PRouzeau/Lily-Big/README.md

# Lily-Big
Boxed delta 3D printer, recycling filtration, kinematic positioning on effector. Print space diam 300 x height 400

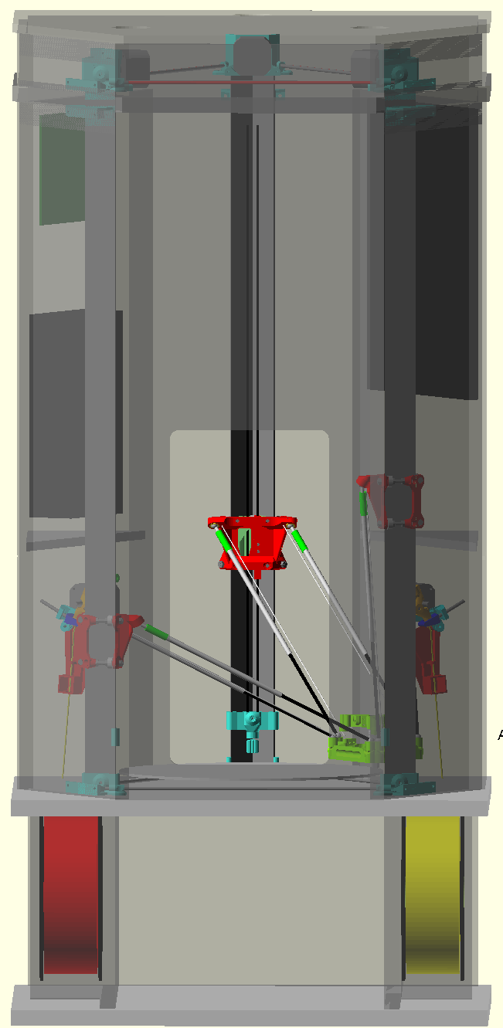
[picture p1: Images/Lily-Big02.png]
Presentation image Example viewed in 3D
