PRouzeau/Lily-Big/Kinematic.odt

As already published in this forum, I am using the wire tensioning system on my two printers since 6 month now, first on the D-Box http://rouzeau.net/Print3D/DBox, then on the Lily http://rouzeau.net/Print3D/Lily.

Retainers are magnets on the D-Box, and rubbers bands on the Lily, to save weight.

The bowden tube tend to pull the hotend support for probe points at the largest diameter, so I had to increase the hotend support pulling value to a minimum. I settled to ~1kg for both machines.

The repeatability is very good in a fixed context, however, the load needed to operate the ‘sensor’ make you machine to deflect of a significant amount, giving a probing offset. As the machine deformations are not the same on all the bed area, you shall individualise offset for each probe point, with calibration done with the sheet paper method.

The offset variability depends a lot of the overall machine stiffness. For the D-Box, I had initially an offset of ~0.4~-0.5mm, with a variability of ~0.15mm. When I replaced the arms by stiffer ones (the weak point was the screwing in plastic on the arms themselves), that reduced sufficiently the offset variability between all points that I abandoned individual offset to a common one, which is now a constant of 0.5 mm for all probing points.

The Lily, while a smaller machine, is a bit less robust (its mechanics cames from the Fisher Delta) and the offset variability remains significant throughout the bed, with values ranging from 0.35 to 0.45 (I have eliminated one point which is off plane).

The only problems I experienced so far :

*I had to retighten the standoffs as their screws tend to became loose with time.

*Heating the D-Box chamber (~70°C)/the bed (tested at 130°C) have driven to effector bending due to wire tension, needing to raise the effector to avoid magnet contacts making the sensor inoperative. The material used (PETG) cannot cope with these temperature tests.

In the Lily « F », there is only yet an halogen spot of 50W which raise slowly the chamber temperature to ~38°C while printing. I will install a heated bed of 100~120W, and will report the obtained temperature (expected below 55°C for Bed 100°C).

ABS may be a better material than PETG, but was not possible for me when I built both printers (no heat bed).
