PRouzeau/Lily-Big/Images/Lily-Big01.png

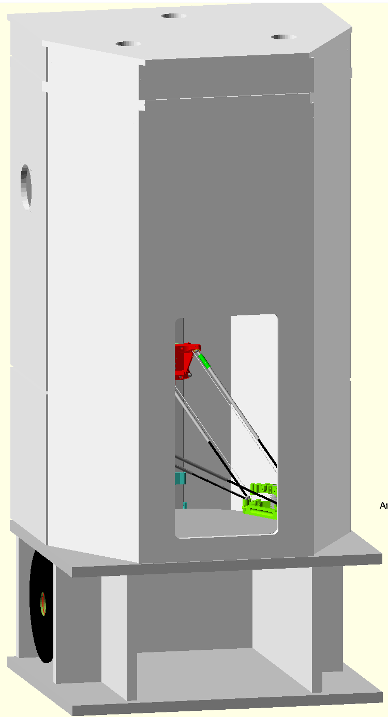
Images/Lily-Big01.png
