PRouzeau/Lily-Big/Images/Lily-Big03.png

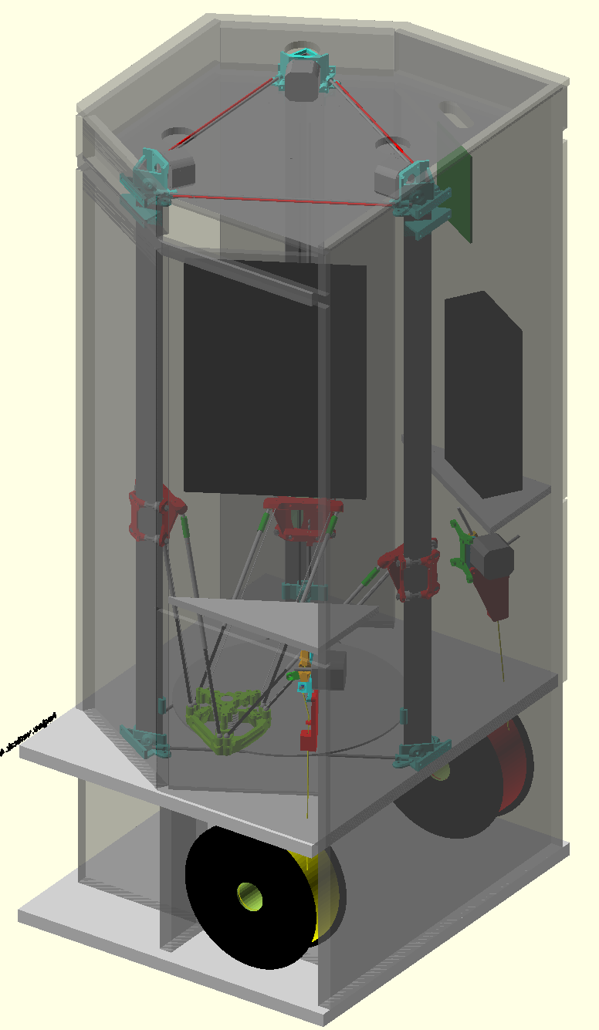
Images/Lily-Big03.png
