PRouzeau/Lily-Big/Images/Lily-Big04.png

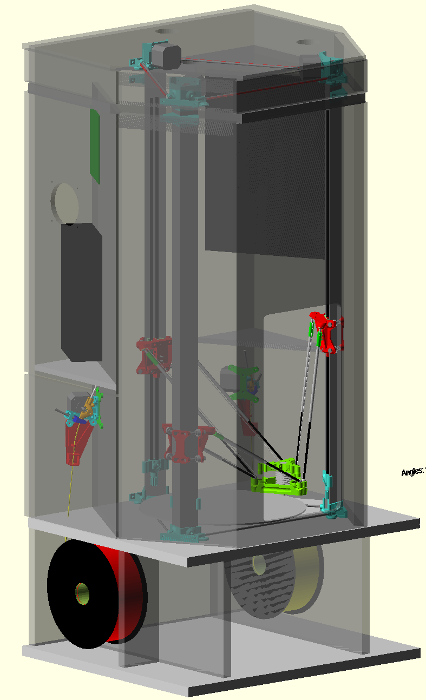
Images/Lily-Big04.png
