PRouzeau/Lily-Big/Images/P1060551.jpg

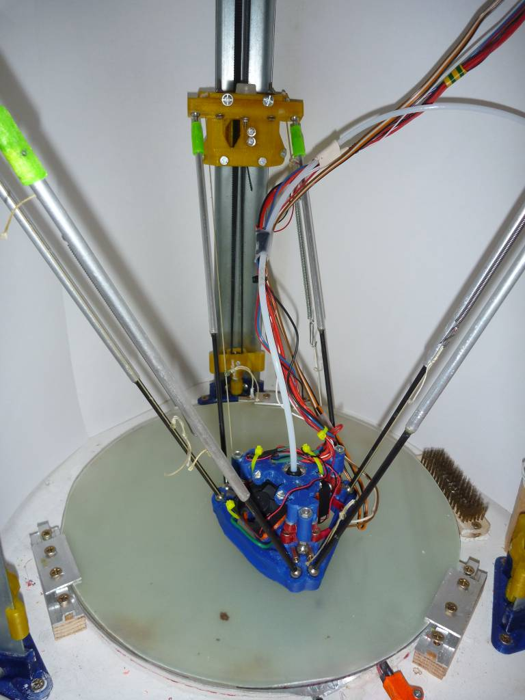
Images/P1060551.jpg
