PRouzeau/Lily-Big/Images/P1060555.jpg

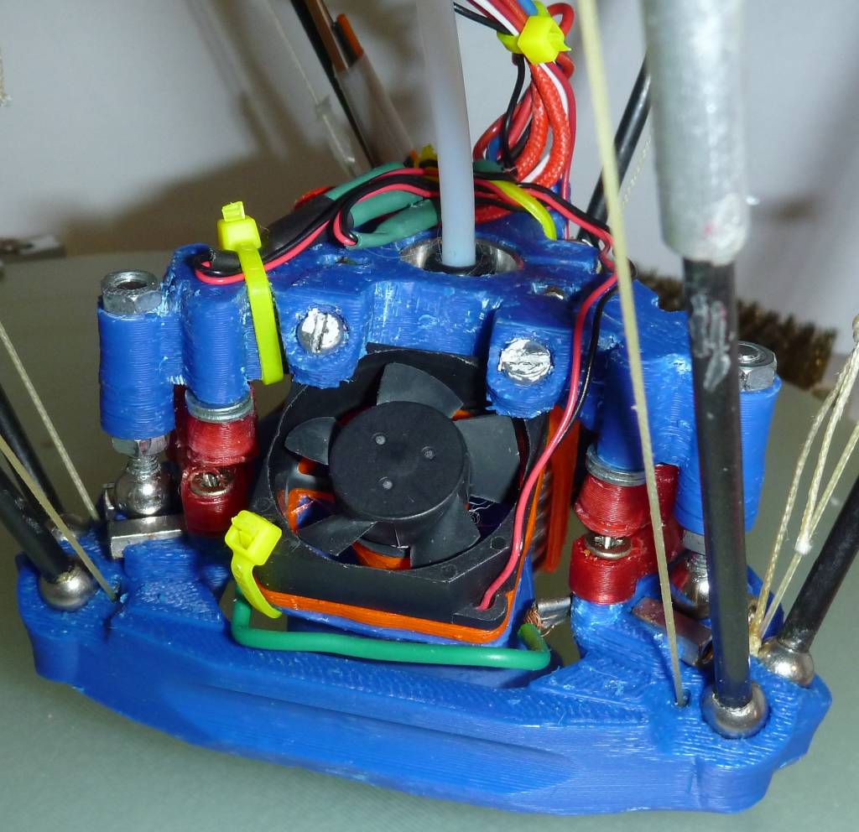
Images/P1060555.jpg
