PRouzeau/Lily-Big/Images/P1060560.jpg

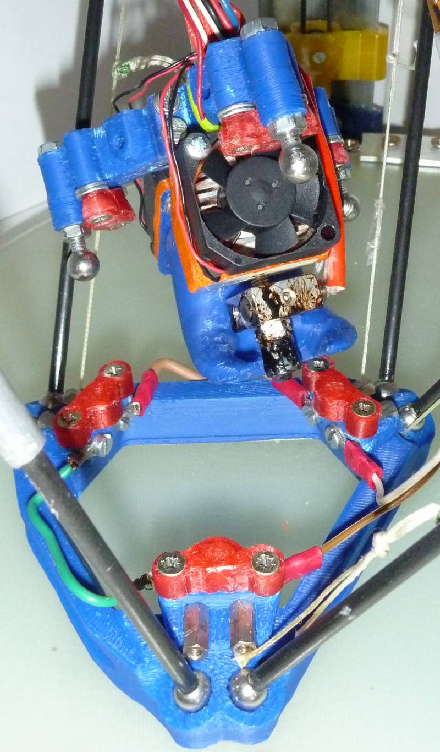
Images/P1060560.jpg
