PRouzeau/Lily-Big/Images/P1060565.jpg

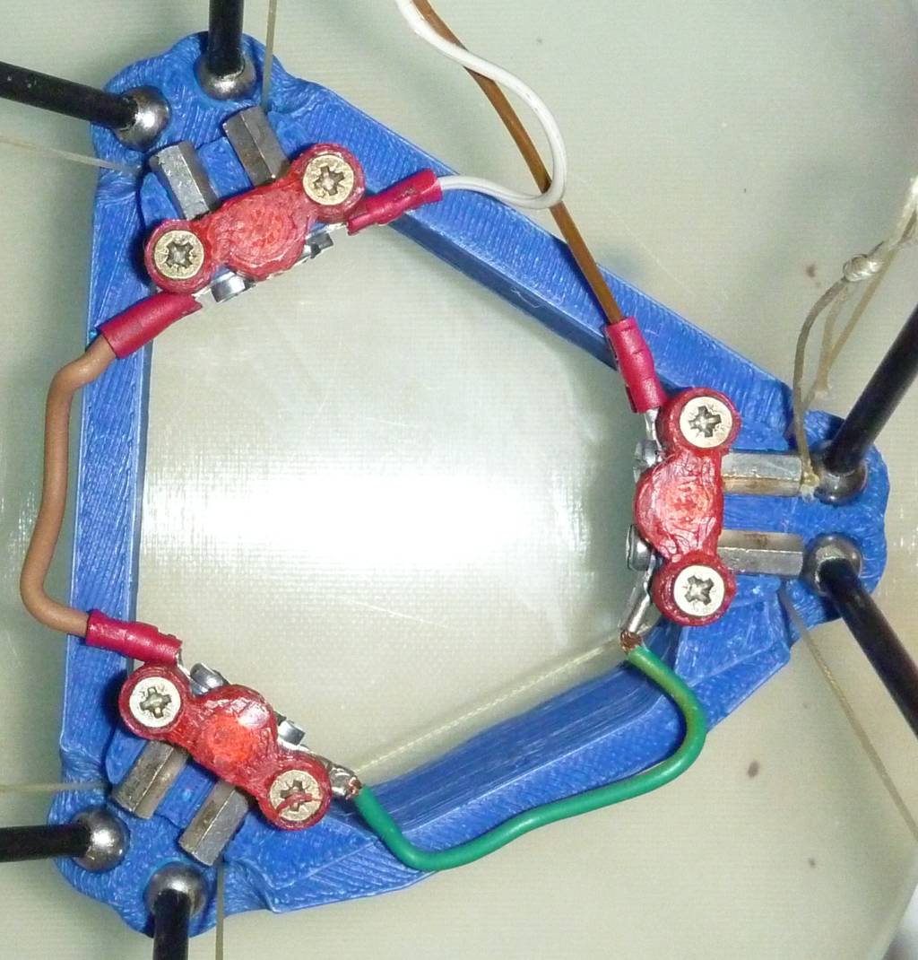
Images/P1060565.jpg
