PRouzeau/Lily-Big/Images/P1060567.jpg

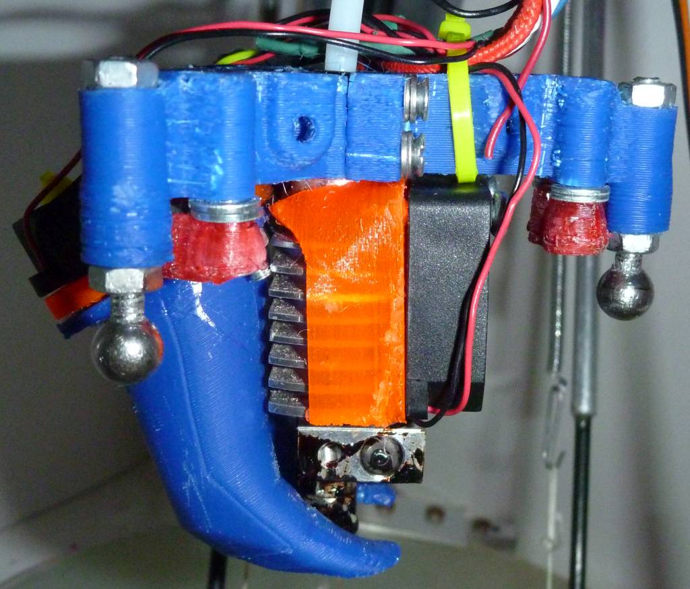
Images/P1060567.jpg
