PRouzeau/Lily-Big/Images/P1060569.jpg

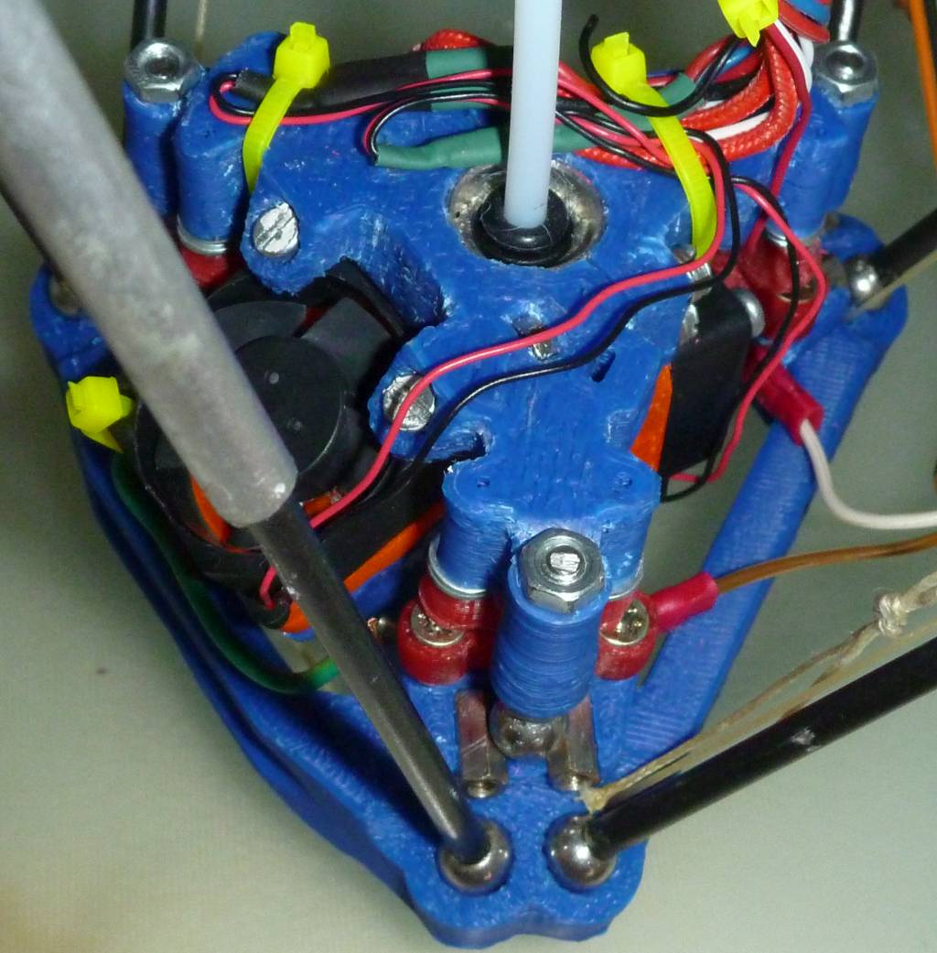
Images/P1060569.jpg
