PRouzeau/Lily-Big/Lily_big_BOM.ods

Sheet: Bolts and Nuts
 | D-Box list , may need update for Lily BIG
 | Size | Usage | Qty | Mult | Total | M3 screws
1 | COLUMNS |  |  |  |  | Cap head
2 | countersunk head screw M4x40 | Carriage ball bearing axis | 4 | 3 | 12 | M3x10 | 12
3 | countersunk head screw M4x10 | Central pusher, bottom | 2 | 3 | 6 | M3x15 | 6
4 | cap head screw M4x20 | Central pusher, top | 2 | 3 | 6 | M3x20 | 12
5 | Domed head M4x20 | Angles anchorings on support | 4 | 3 | 12 | M3x25 | 7
6 | Domed head M4x20 | Top support anchoring | 4 | 3 | 12 | M3x30 | 6
7 | cap head M4x40 | Tensioner | 1 | 4 | 4
8 | Nuts M4 |  | 23 | 3 | 69 | countersunk head
9 | Small washers M4 |  | 13 | 3 | 39 | M3x8 | 8
10 | Cap head screw M3x15 | Belt locker attach | 2 | 3 | 6 | M3x10 | 4
11 | cap head screw M3x20 | Ball bar attach | 2 | 3 | 6 | M3x15 | 2
12 | Cap head M3x10 | motor attach (W/ cork insulator) | 2 | 3 | 6
13 | Cap head M3x25 | Top rubber stop attach | 1 | 3 | 3 | Standoffs
14 | Cap head M3x30 | bottom motor bar attach | 2 | 3 | 6 | M3x10 | 6
15 | countersunk head screw M3x25 | Idler bearings | 1 | 3 | 3 | M3x25 | 4
16 | Nuts M3 |  | 8 | 3 | 24
17 | Medium washers M3 |  | 12 | 3 | 36 | nuts | 36 | 57
18 | Rods M4 * 333 | column positioning | 2 | 3 | 6
19 | M4 nuts | '' | 8 | 3 | 24
20 | M4 small washers | '' | 8 | 3 | 24
21 | EFFECTOR |  |  |  |  | washers S | 4
22 | Cap head M3x10 | Kinematic standoff attach | 6 | 1 | 6 | washers M | 48 | -18
23 | Cap head M3x20 | Fan attach | 2 | 1 | 2 | washers L | 4
24 | Cap head screw M3x20 | Hotend support assembly | 4 | 1 | 4
25 | Round or hex standoff M3x10 | Kinematic standoff | 6 | 1 | 6
26 | Medium washers M3 |  | 6 | 1 | 6 | M4 screws
27 | Nuts M3 |  | 6 | 1 | 6 | Domed head
28 | threaded rod M4x30 | Hotend support | 3 | 1 | 3 | M4x20 | 24
29 | threaded rod M4x30 | Arms ends | 6 | 1 | 6
30 | Nuts M4 |  | 9 | 1 | 9 | cap head
31 | EXTRUDER (for 2) |  |  |  |  | M4x20 | 12
32 | countersunk head screw M3x8 | Motor attach | 4 | 2 | 8 | M4x40 | 8
33 | countersunk head screw M3x10 | Attach to antivibration plate | 4 | 1 | 4
34 | countersunk head screw M3x15 | Attach of filament guide plate | 2 | 1 | 2 | countersunk head
35 | M3 nut |  | 6 | 1 | 6 | M4x10 | 6
36 | Medium M3 washer |  | 6 | 1 | 6 | M4x20 | 2
37 | countersunk head screw M4x20 | Bearing attach | 1 | 2 | 2 | M4x40 | 16
38 | Hex head M4x30 | Tensioner | 1 | 2 | 2
39 | M4 nut |  | 1 | 2 | 2 | Hex head
40 | M4 butterfly nut |  | 1 | 2 | 2 | M4x20 | 2
41 | M4 medium washer |  | 1 | 2 | 2 | M4x30 | 2
42 | M4 large washer |  | 1 | 2 | 2
43 | BOARD |  |  |  |  | Threaded rods
44 | Hex standoff M3x25 | Spacer for board | 4 | 1 | 4 | M4x30 | 9 | 72
45 | Cap head M3x25 | Attach spacer to panel | 4 | 1 | 4 | M4x 333 | 6
46 | Cap head M3x10 | Attach board to spacer | 4 | 1 | 4 | Nuts | 129
47 | Small washer M3 |  | 4 | 1 | 4 | Butterfly nut | 4
48 | Large washer M3 |  | 4 | 1 | 4
49 | SPIGOTS |  |  |  |  | washers S
50 | Hex head M4x20 |  | 1 | 2 | 2 | washers M
51 | M4 nut |  | 1 | 2 | 2 | washers L
52 | M4 medium washer |  | 1 | 2 | 2
53 | Other
54 | cap head M4x40 | Power supply attach | 4 | 1 | 4
55 | countersunk head screw M4x40 |  | 2 | 2 | 4
56 | M4 Nuts |  | 23 | 1 | 23
57 | Medium washer M4 |  | 12 | 1 | 12
58
 | Additional bolts and nuts may be needed for :
 | Tool holder | M3
 | Tool changer | M3
 | Chamber heater | M4
 | Bed | M3/M4
 | Hinges | M3
 | Bearings
 | F623ZZ | idlers | 6 | 1 | 6
 | 624ZZ | carriage | 6 | 3 | 18
 | 624ZZ | Extruder bearing | 1 | 2 | 2

Sheet: Buy
 | Cost in Euros. This does includes 20 % VAT and shipping to France. Shipping to other countries may be more costly
 | A lot of buys were small buy and I never paid any VAT nor Custom for foreign supply, may have been only applicable for hotend
 | Everything arrived, from China in 10 days to 5 weeks
 | Some prices done from memory, so may not be completely accurate
 | There is a lot of stuff for printer available in UK but shipping cost is very high. You can find more reasonnable shipping cost from the rest of Europe
 | This BOM is supposed to be exhaustive
 | Description | Ref/Dimensions | Qty | Supplier | From
1 | Control Board | Duet 0.8.5/Duet WiFi | 1 | T3P3 | UK | 155.00
2 | Hotend Prometheus | V 2.0 | 1 | Distech | Canada | 82.00 | 3 days delivery from Canada
3 | Steppers 0,9°, 4,2 kg.cm | Wantai/Sparkfun 42BYGHM809 | 3 | Robotshop | EU dispatch | 64.00 | Don't have high torque (5,2 kg.cm 1,8°) for the extruder
4 | Stepper 1,8°, 5,2 kg.cm | 17HS8401 | 1 |  |  | 24.00
5 | Steel balls diam 8mm – 15 needed | Diam 8, untapped hole 4 | set of 50 | Animation armatured | UK | 14.95
6 | Mechanical Bolts & nuts | See detailed list |  | Fixnvis | France | 30.00
7 | Filament | ~700g | Set |  | - | 20.00
8 | Cold formed steel angle | 40x40x2, length 2,40m | 1 | DIY store | France | 24.00
9
10 | Box
11 | Wood panels |  |  | DIY store | France | 60.00 | needs precise cut – choose your supplier
12 | Power supply chord | Length 5m | 1 | DIY store | France | 5.00 | Wanting a long chord, cannot salvage computer one
13 | Rubber feet | For box and carriage top | 2 sets of 4 | DIY store | France | 6.00
14 | Hinges (6 total) | 50x30 (width 15) | 3 pairs | DIY store | France | 3.60
15 | Door hinge (dismountable, 2 total) | 50x40 | 1 pair | DIY store | France | 3.50
16 | Door magnets (needed 8) | 4kg | set of 10 | DIY store | France | 5.95
17 | Door tempered glass | 200 x 400 x 6mm | 1 | DIY store | France | 5.00
18 | Low-density foam weatherstrip | Width 10mm x thickness 5mm | 1 roll 5m | DIY store | France | 6.00 | Buy good quality, branded
19 | Wood screw | 3x40 | Box 200 | DIY store/Internet | France | 12.00 | BOX price
20 |  | 3x20 | 50 |  | France | 15.00 | 122.05
21 | Wood screw | 3x15 | 50 |  | France | 4.00
22 |  | 4x25 | 50 |  | France | 4.00
23 |  | Misc |  |  | France | 4.00
24 | Paint | Acrylic
25 | Rigid wire red/blue/earth | HO7VU 1,5 mm² | 3x 1m | DIY store | France
26 | cable for bed and chamber heater | U1000R2V 3x1,5mm² | 2m | DIY store | France
27 | Bed rockwool panel insulator | Chimney hopper insulation pyrofeu | 500x500x5 | DIY store | France | 18.00
28 | Bulb socket (chamber heater) |  | set of 5 | DIY store | France | 6.00 | Don’t work well
29 | Spectra/Dyneema wire | Kite wire > 40 kg (diam ~1mm) | 1 roll | Sport shop | France | 4.95 | Maybe easier to use nylon 16kg
30 | Piano wire for wire hooks | 0,8 mm x 1m |  | Model shop | France | 1.00
31 | Aluminium tubes | diam 6mmx1mm, length 1m | 2 | DIY store | France | 5.20
32 | Carbon rod | diam 4mm, length 1m | 1 m | Sport/Model store | France | 4.90
33 | Kitchen activated carbon filter |  | 1 set | Supermarket | France | 4.00
34 | Magnets | diam 6x6 | 1 set of 10 | Supermagnete | Germany | 8.75 | Shipping more costly than magnets
35 | Board cooling fan and recycling fan | 60x60x15, 24V or 5V | 1 | Salvaged
36 | Recycling fan | 80x80x20, 24V or 5V | 2 |  |  | 8.00 | 1 is controlled (heat exhaust from chamber)
37 | standoffs for kinematic system | M3x10, hex type | set of 10 | ebay | China
38 | Part & hotend cooling fan 30x30x10 | sunon 30x30x10 5V | 2 | ebay | Germany | 18.20 | Costly, but good quality, 5v easier on Duet WiFi
39 | Fan guard | 60x60 Got a fan with the guard ! | 1 | ebay | China | 2.10
40 | Emergency shutdown button | 10A , 600V | 1 | ebay | China | 1.83
41 | SSR AC for bed and chamber | Fotek SSR-25 DA | 2 | ebay | China | 3.36
42 | Power supply 24V, 200W mini | bought 350W (Bed is on 230V) | 1 | ebay | UK dispatch | 32.00
43 | DC-DC buck converter w/ display | For 12V fan power supply | 1 | ebay | China | 3.50
44 | DC-DC 5V converter | 24-5V converter, board supply | 1 | ebay | China | 5.40
45 | Power switch | 250V, 6A mini | 1 | ebay | China | 3.00
46 | 24V switch | 120V, 10A mini | 1 | ebay | China | 2.00
47 | Insulated pin terminals | Set of 800 | 1set | ebay | China | 10.76
48 | Screw terminal blocks | 2x6 | 3 | ebay | China | 3.75
49 | Brass wire brush (hotend cleaner) | brass wires, not brass plated steel | 1 | ebay | China | 1.45
50 | Panel Fuse holder 6x32 | 5 6x32 holders, welded ends | 1 set of 5 | ebay | China | 2.19
51 | Fuses 6x30 – 1x6A, 1x10A | Set of 72 quick fuses 6x30 | 1 set | ebay | China | 4.45
52 | Dupont cables for motors | 70cm, females plugs/4pins | 1 set of 10 | ebay | China | 4.27
53 | Dupont cables for switches | 70cm, females plugs/3pins | 1 set of 10 | ebay | China | 3.50
54 | Pulleys GT2-2 16 Teeth | Bought 4 – 1 spare | 4 | ebay | China | 6.52
55 | Dupont connectors | set on demand |  | ebay | France | 11.30
56 | Small switches | set of 10 |  | ebay | China | 1.36 | Cost includes shipping !
57 | 100 k Thermistor with 1m wire 5 (2 unit – One extra) |  |  | ebay | China | 2.58 | Choose the one who indicates the coefficient
58 | Resistors for temp calibration | 100k (x10) + 220 (x10) |  | ebay | France | 2.40
59 | Zip-ties | 100x2,5 |  | ebay | China | 2.70
60 | Ribbon cable, multi-colors | 12 strands, 26AWG | 1 m |  | China | 3.00
61 | Idler ball bearings | F623ZZ | 1 set of 10 | ebay | China | 8.00
62 | Carriage ball bearings | 624ZZ | 2 sets of 10 | ebay | China | 4.56
63 | Thermo-retractable sleeves |  | 1 set | ebay | China
64 | Set of springs |  | 1 set | ebay | UK/China | 12.00
65 | Silicon bed heater | Dia 300mm 280W,230V+thermistor | 1 | ebay/jsr.industrial | China | 44.00
66 | Ceramic heaters for chamber | 100W, E27 terrarium ceramic heater | 4 | ebay | China | 17.20 | Not yet properly working – need shielding : 400°C !
67 | Aluminium plate for bed | plates 300x300x3 | 1 set of 4 | ebay | France | 20.00
68 | Bed glass | dia 300mm , thk 5mm | 1 m | ebay | UK | 32.50
69 | Hobbed insert | MK8 for 1.75mm, stainless steel | 1 | ebay | Spain | 6.00 | Shall be SPECIFIC for 1.75 mm
70 | Bowden tube | Diam 4x2 , length 1m |  | Reprap.me | Denmark | 5.24 | More stiff than others (this is good!)
71 | Cork insulators | 1 set of 5 |  | Reprap.me | Denmark | 2.93
72 | Belts GT2-2mm | 5 m |  | Reprap.me | Denmark | 23.20 | Better quality than those bought on ebay
73 | Reprap.me shipping |  |  | Reprap.me | Denmark | 7.20
74
75 |  |  |  |  |  | 923.25
76 | For a second extruder (no shipping if bought with other)
77 | Prometheus hotend |  |  | Distech |  | 70.00
78 | Bowden tube |  |  |  |  | 5.24
79 | MK8 drive gear |  |  |  |  | 4.20
80 | Nuts and bolts |  |  |  |  | 3.00
 |  |  |  |  |  | 82.44
 | Tools
 | Epoxy glue
 | Thread lock glue
 | Spanners | 5,5 ; 7 ; 8 (x2) ; 18 |  | DIY store/amazon
 | Crimp tool for uninsulated terminals | Weierli SN-28B - Ratchet type |  | ebay | China | 12.06 | Needed for Dupont connectors
 | Crimp tool for insulated terminals | Silverline PL55 |  | ebay | France |  | Needed for any electrical flexible wire
 | Digital calipers | 150mm |  | Supermarket | France | 10.00
 | Tweezers |  |  | ebay | China
 | Infrared hand temperature measure | Testo 830-T2 |  | conrad | Germany
 | Electric multi-meter | Schneider IMT23002 |  | amazon | France |  | The lowest cost branded controller
 | Wire cutting tool |  |  | ebay | China
 | Hot air gun/hair dryer |  |  | ebay | EU dispatch

Sheet: Printed
Lily Big print parts |  |  |  | PRZ | CC BY-SA , OHL 1.2
 | Material : ABS or higher temperature resistant plastic
 | Plastic density | 1.1 |  | fill in : 70 % | Layer 0.3 mm | 3 walls
 | Average Density (partial fill-in) | 0.95 |  |  | Bottom 5 layers | Top 3 layers
 | High density (fill-in 70%) | 1
 |  | raw | filament | Weight
 |  | cm³ | cm³ | g
Moving for one column
15 | Carriage | 32.6 |  | 30.97
18 | Ball cups for carriage | 0.7 |  | 0.67
16 | Carriage center | 11.6 |  | 11.02
17 | Carriage back | 5 |  | 4.75
Total |  |  |  | 47 | g
Print for one column see Direct extruder repository
02 | foot | 21.2 |  | 21.20
03 | motor support | 30.6 |  | 30.60
11 | motor plate | 4.9 |  | 4.66
04 | Top reinforcment | 9.6 |  | 9.12
05 | Angle plug | 3.25 |  | 3.09
12 | Tensioner | 9.2 |  | 8.74
13 | Tensioner thumb | 1.1 |  | 1.05
14 | Nut retainer | 1.4 |  | 1.33
19 | belt clamp | 4.5 |  | 4.28
20 | Arm junctions (4) | 5.5 |  | 5.23
Total |  |  |  | 89 | g
Print per extruder
08 | Extruder base | 8.5 |  | 8.08 | Mirrorred : 09
22/24 | Extruder lever | 5 |  | 4.75 | Mirrorred : 23 or 25
10 | Anti-vibration support | 3.8 |  | 3.61 | Mirrorred : 11
30 | Tensioner | 1.4 |  | 1.33
20 | Spongebox | 2.4 |  | 2.28
32 | Thumbwheel | 2.7 |  | 2.57
 | Spigot 95 | 10.2 |  | 9.69
Total |  |  |  | 32
Print once
30 | Effector | 47.3 |  | 44.94
37 | hotend support1 | 12.8 |  | 12.16
38 | hotend support2 | 7.5 |  | 7.13
33/34/35 | Part duct | 4.3 |  | 4.09 | Duct print need special profile
32 | Mag holders | 5 |  | 4.75
29 | ESD cover | 16 |  | 15.20
44 | Glass clamp | 8 |  | 7.60
22 | Name plate | 2.4 |  | 2.28
Single parts |  |  |  | 98
Total |  |  |  | 540 | g
PARTS
Note that part 31 shall not be printed (used only for modelling)
You shall choose duct 33,34 or 35 depending the nut quantity on Prometheus
For E3D V6 use duct 34
Part 31 is a template for column spacing and the STL proposed is for Lily Big
So it give appropriate dimensions with the panels DXF
Part 23 (SSR protection) may not be needed if you got SSR with shields
Part 39 is for 30x30 fan on Prometheus, not needed with original 25x25 fan
Part 29 is foreseen to install shutdown button in a more accessible place than printer top
STL part can be rebuilt by executing all the batch files
These batch files are for Windows and shall be adapted for other OS
