PRouzeau/Lily-Big/Lily_big_panels.ods

Lily Big box panels
Melaminated chip board, thickness 10 and 18mm – Melamine is a fire retardant
Panels thickness 18 mm |  | 13 | kg/m²
Tag | Description | Dim 1 (cm) | Dim 2 (cm) | Thk | Qty | Surface (m²) | Weight (kg) | Comment
- | Base support | 22 | 43 | 18 | 2 | 0.19 |  | Size shown in console message
- | Base spool separator | 22 | 8 | 18 | 2 | 0.04 |  | Size shown in console message
52 | Back panel | 110 | 51 | 18 | 1 | 0.56 |  | Automatic export with batch
51 | Front sides | 78 | 22 | 18 | 2 | 0.34 |  | Automatic export with batch
53/54 | Back sides | 78 | 26.5 | 18 | 2 | 0.41 |  | Automatic export with batch
61 | Bottom | 54 | 47 | 18 | 1 | 0.25 |  | Automatic export with batch
62 | Mid panel | 54 | 45 | 18 | 1 | 0.24 |  | Automatic export with batch
65 | Top panel | 54 | 45 | 18 | 1 | 0.24 |  | Automatic export with batch
63 | Separator (triangles) | 23 | 13 | 18 | 2 | 0.06 |  | Automatic export with batch
 | Total panels 18mm |  |  |  |  | 2.34 | 30.44
Panels thickness 10mm |  | 8 | kg/m²
Tag | Description | Dim 1 (cm) | Dim 2 (cm) | Thick | Qty | Surface (m²) | Weight (kg)
55/56 a | Door bottom | 26 | 26 | 10 | 2 | 0.14 |  | Automatic export with batch
55/56b | Door top | 26 | 51.5 | 10 | 2 | 0.27 |  | Automatic export with batch
57 | Front door | 78 | 30.5 | 10 | 1 | 0.24 |  | Automatic export with batch
66 | Cover | 54 | 47 | 10 | 1 | 0.25 |  | Automatic export with batch
 | Total panels 10mm |  |  |  |  | 0.89 | 7.16
Standard plywood, 5mm thickness
 | Filter retainer | 35 | 23 | 5 | 1 | 0.08
Lath 60x20 or 60x18
 | Top box front | 30.5 |  |  | 1
 | Front sides | 22 |  |  | 2
 | Back sides | 26 |  |  | 2
Assembly with good quality wood screws 3x15 and 3x40
