PRouzeau/Lily-Big/DXF/Lily_Big_61_bottom.dxf

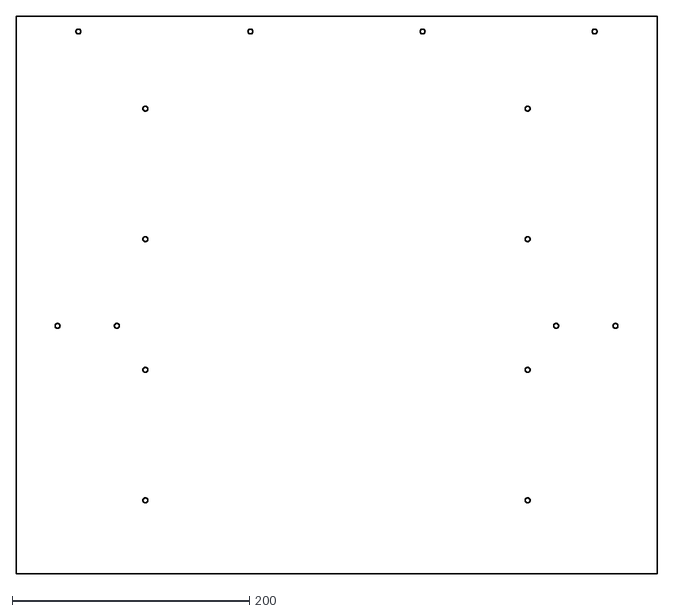
[picture p11: CAD file, 2016-08-03]
DXF/Lily_Big_61_bottom.dxf
540.0 x 470.0
