PRouzeau/Lily-Big/STL_Big/Lily_Big_33_part_duct1.stl

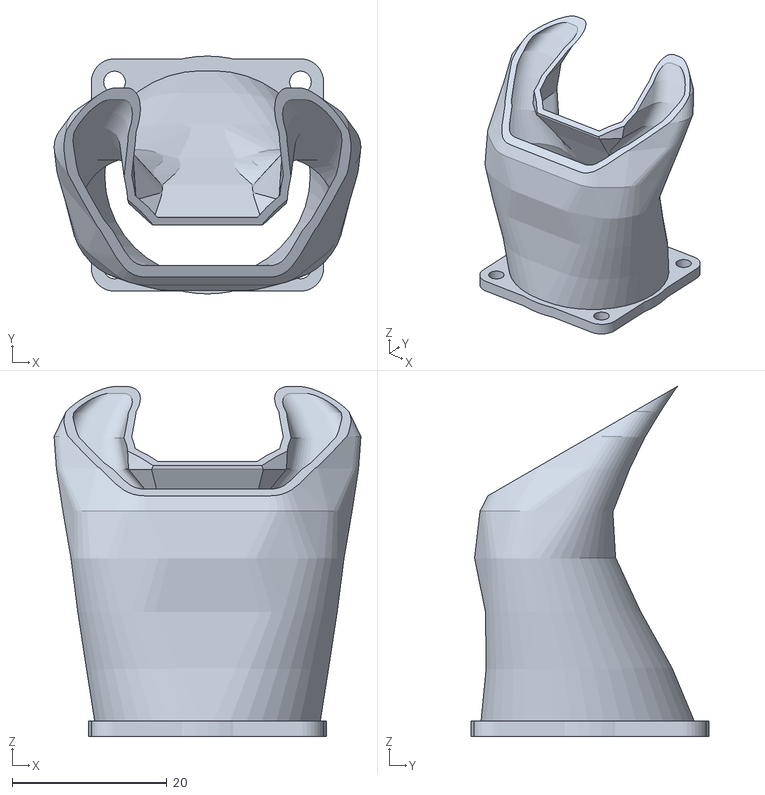
[picture p12: CAD file, 2016-08-03]
STL_Big/Lily_Big_33_part_duct1.stl
39.6 x 30.7 x 45.2
