PRouzeau/Lily-Big/STL_Dirext/Dirext_24_Lever_Pushfit.stl

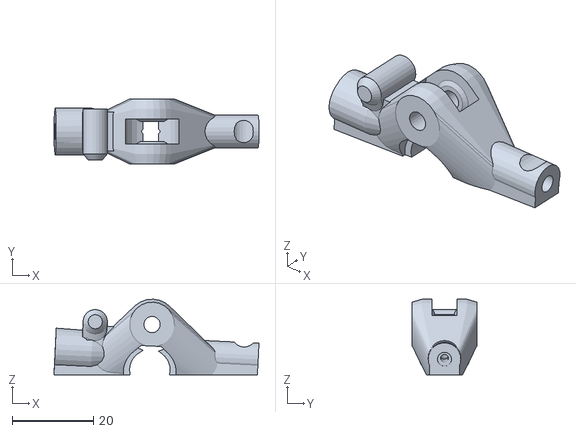
[picture p13: CAD file, 2016-08-03]
STL_Dirext/Dirext_24_Lever_Pushfit.stl
50.4 x 16.0 x 18.6
