PRouzeau/Lily-Big/DXF/Lily_Big_52_back_panel.dxf

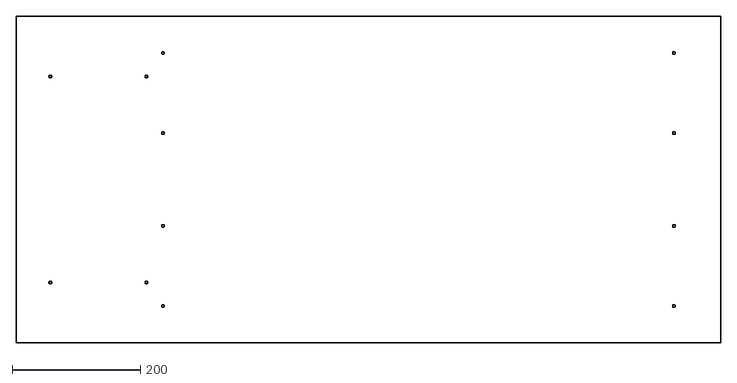
[picture p14: CAD file, 2016-08-03]
DXF/Lily_Big_52_back_panel.dxf
1100.0 x 510.0
