PRouzeau/Lily-Big/STL_Big/Lily_Big_37_hotend_support_B1.stl

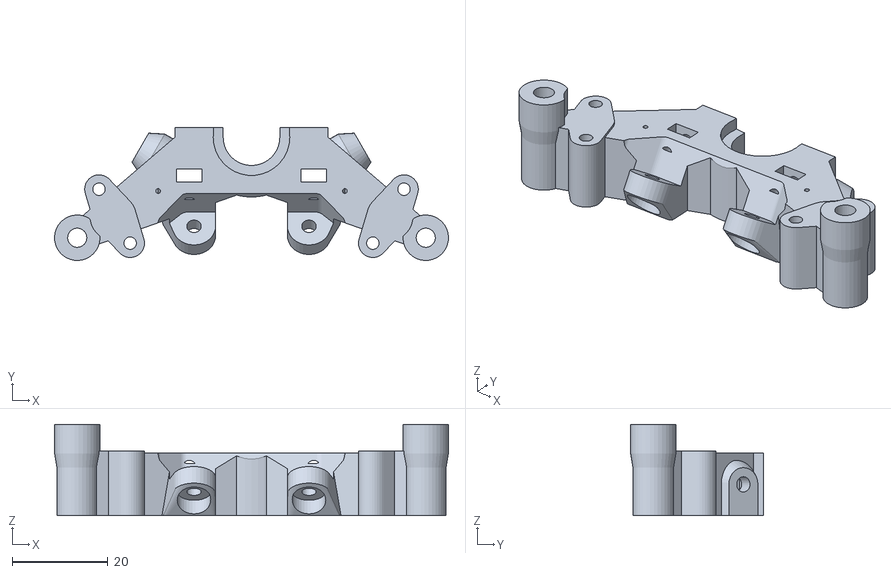
[picture p15: CAD file, 2016-08-03]
STL_Big/Lily_Big_37_hotend_support_B1.stl
82.2 x 27.7 x 19.0
