PRouzeau/Lily-Big/STL_Dirext/Dirext_32_Thumbwheel.stl

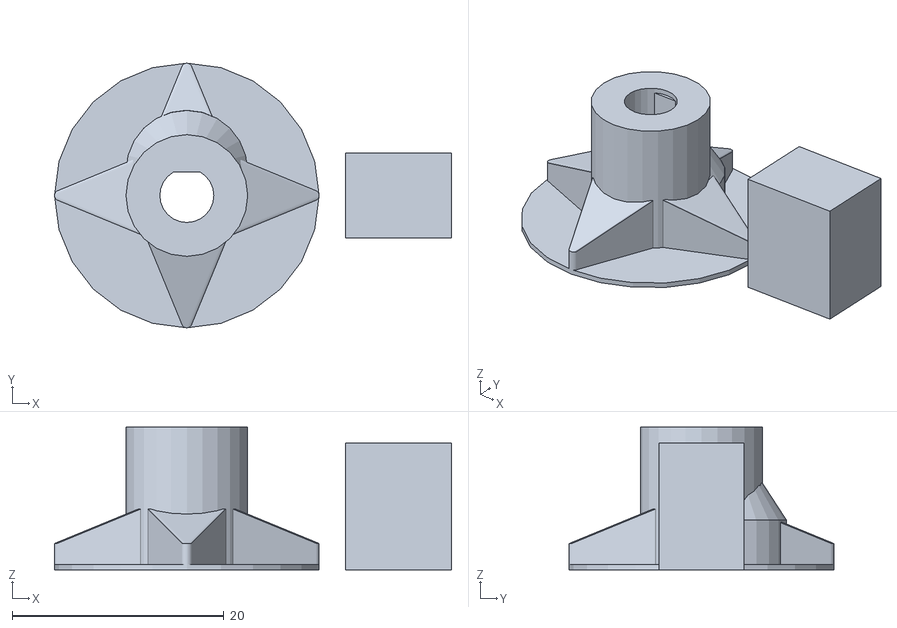
[picture p16: CAD file, 2016-08-03]
STL_Dirext/Dirext_32_Thumbwheel.stl
37.5 x 25.0 x 13.5
