PRouzeau/Lily-Big/DXF/Lily_Big_51_front_panels.dxf

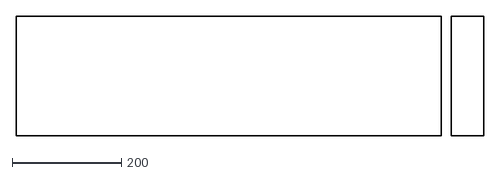
[picture p17: CAD file, 2016-08-03]
DXF/Lily_Big_51_front_panels.dxf
858.0 x 220.0
