PRouzeau/Lily-Big/STL_Big/Prometheus2nuts.stl

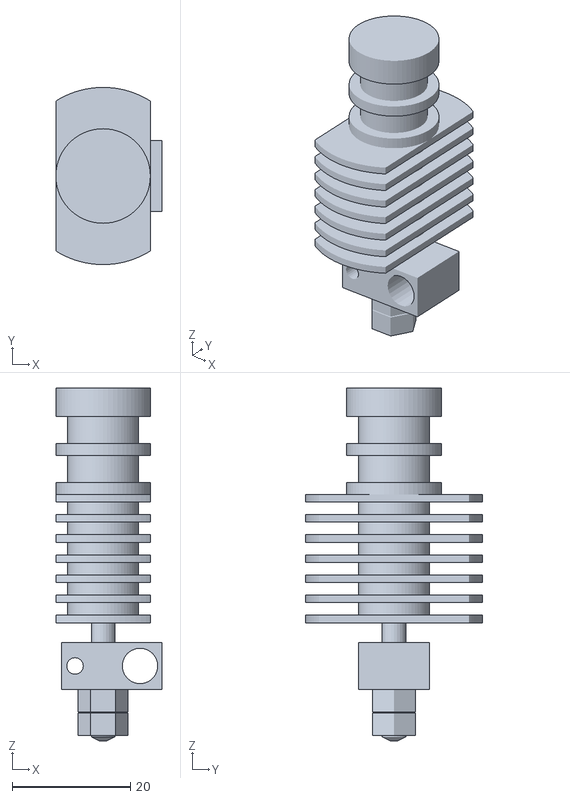
[picture p18: CAD file, 2016-08-03]
STL_Big/Prometheus2nuts.stl
18.0 x 30.0 x 59.8
