PRouzeau/Lily-Big/STL_Dirext/Dirext_15_Simple_extr_filguide_vert_mirrored.stl

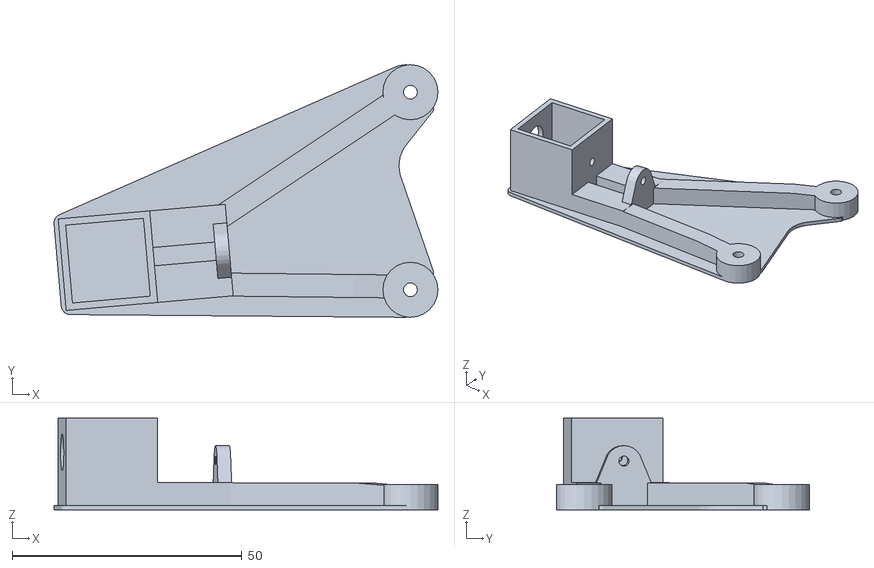
[picture p19: CAD file, 2016-08-03]
STL_Dirext/Dirext_15_Simple_extr_filguide_vert_mirrored.stl
83.6 x 55.0 x 20.0
