PRouzeau/Lily-Big/DXF/Lily_Big_54_right_side.dxf

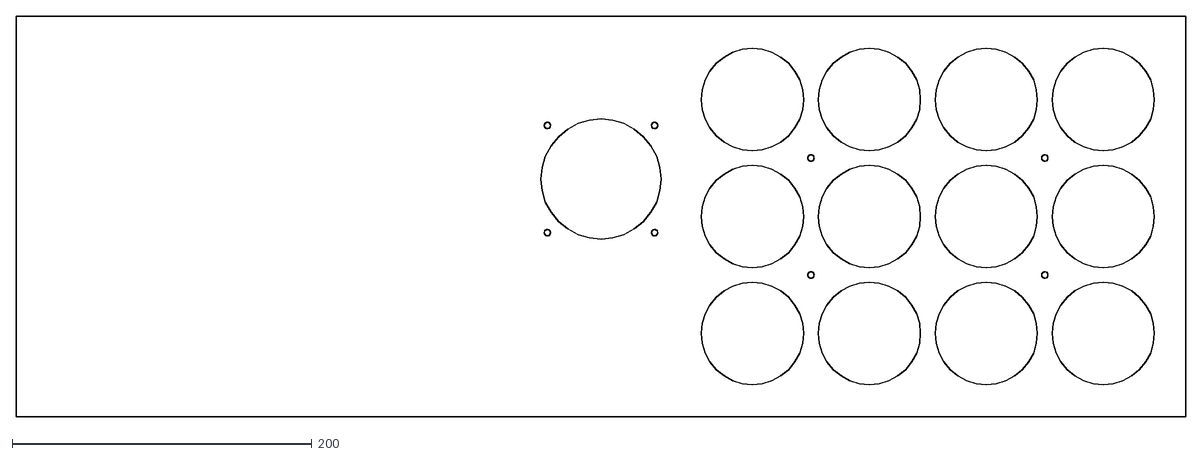
[picture p20: CAD file, 2016-08-03]
DXF/Lily_Big_54_right_side.dxf
780.0 x 267.0
