PRouzeau/Lily-Big/STL_Big/Lily_Big_11_motor_plate.stl

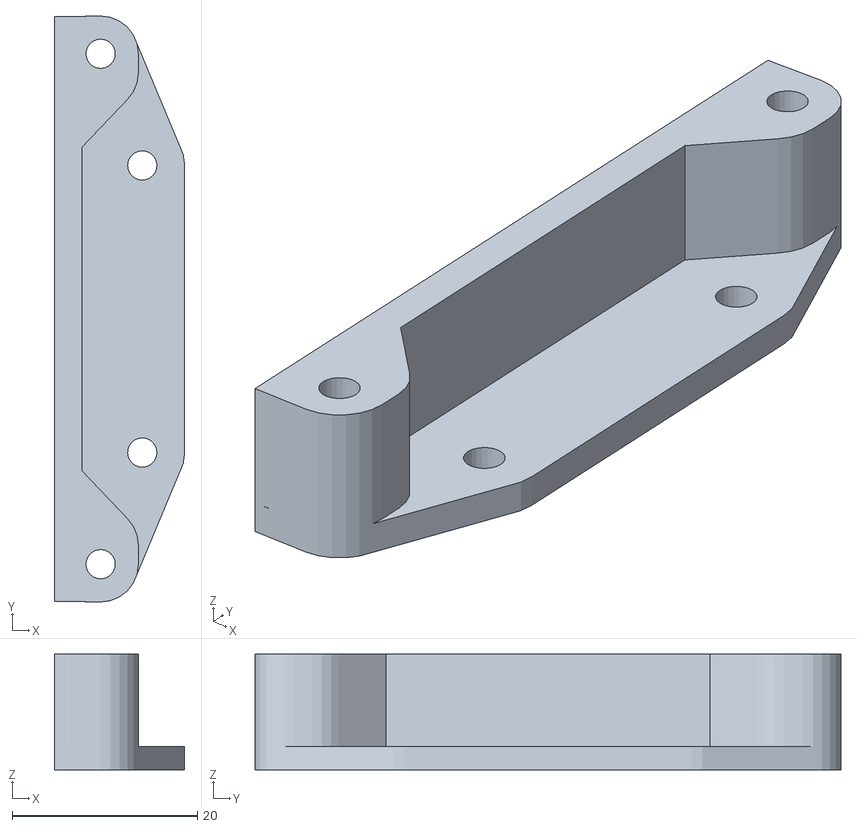
[picture p21: CAD file, 2016-08-03]
STL_Big/Lily_Big_11_motor_plate.stl
14.1 x 63.3 x 12.5
