PRouzeau/Lily-Big/STL_Dirext/Dirext_09_Simple_extr_base_mirrored.stl

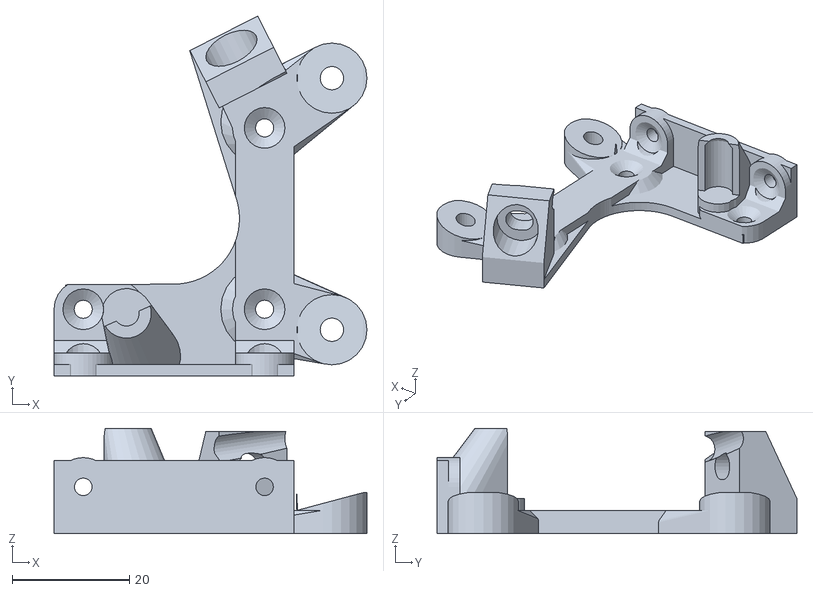
[picture p22: CAD file, 2016-08-03]
STL_Dirext/Dirext_09_Simple_extr_base_mirrored.stl
53.5 x 61.5 x 18.0
