PRouzeau/Lily-Big/DXF/Lily_Big_62_mid_panel.dxf

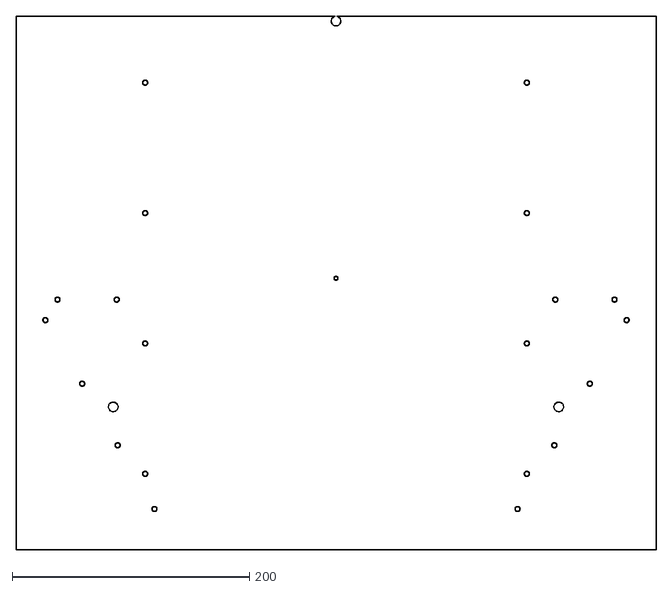
[picture p23: CAD file, 2016-08-03]
DXF/Lily_Big_62_mid_panel.dxf
540.0 x 450.0
