PRouzeau/Lily-Big/STL_Big/Lily_Big_22_name_plate.stl

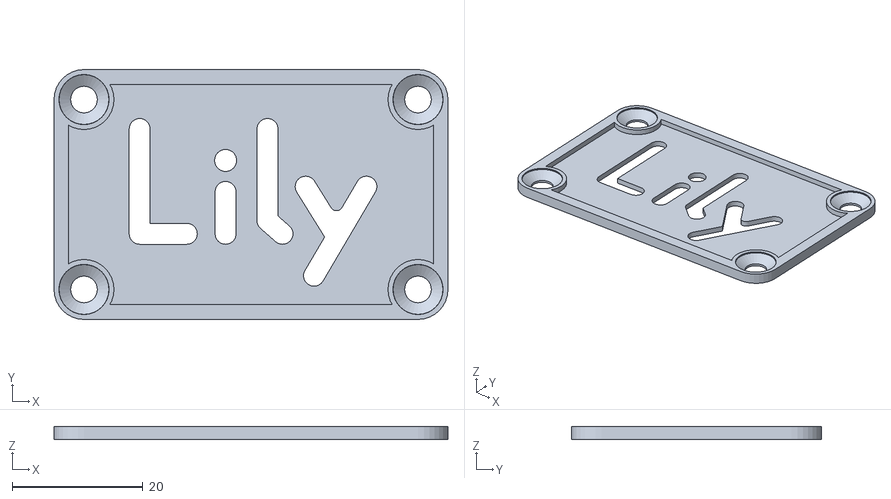
[picture p24: CAD file, 2016-08-03]
STL_Big/Lily_Big_22_name_plate.stl
60.2 x 38.2 x 2.00
