PRouzeau/Lily-Big/STL_Dirext/Dirext_22_Lever_NutM4.stl

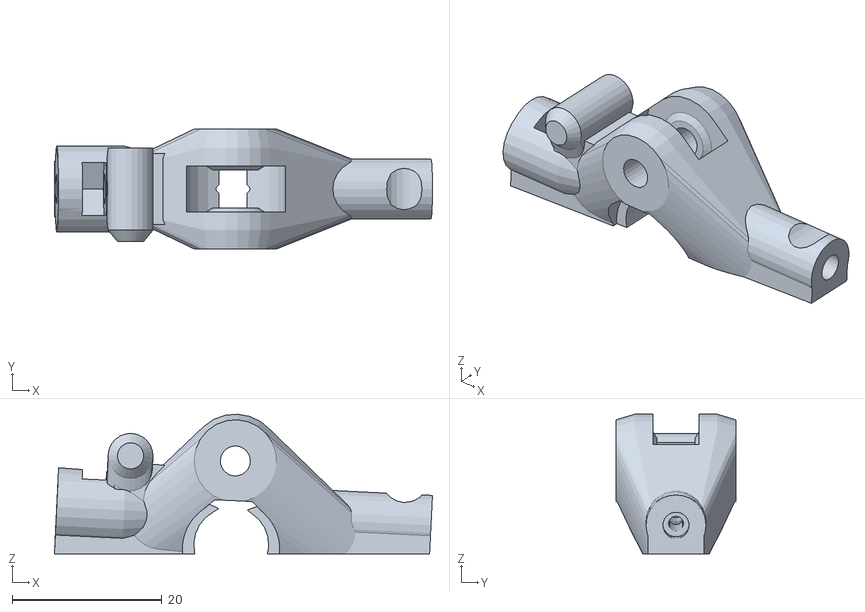
[picture p25: CAD file, 2016-08-03]
STL_Dirext/Dirext_22_Lever_NutM4.stl
50.4 x 16.0 x 18.6
