PRouzeau/Lily-Big/DXF/Lily_Big_66_cover.dxf

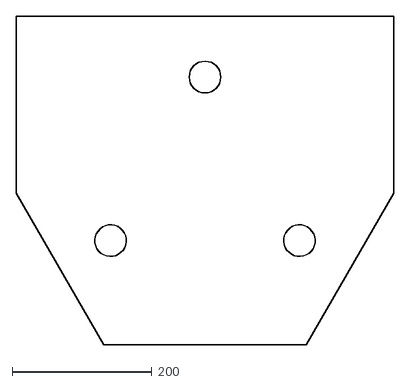
[picture p26: CAD file, 2016-08-03]
DXF/Lily_Big_66_cover.dxf
540.0 x 470.0
