PRouzeau/Lily-Big/STL_Big/Lily_Big_19_belt_attach.stl

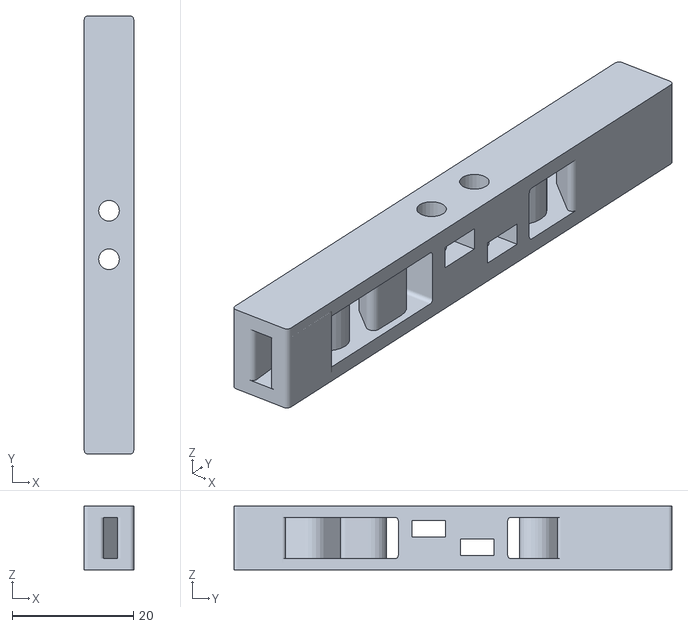
[picture p27: CAD file, 2016-08-03]
STL_Big/Lily_Big_19_belt_attach.stl
8.20 x 72.2 x 10.5
