PRouzeau/Lily-Big/DXF/Lily_Big_63_separator.dxf

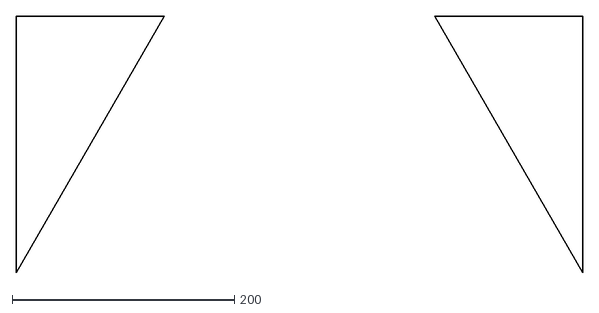
[picture p28: CAD file, 2016-08-03]
DXF/Lily_Big_63_separator.dxf
510.0 x 231.1
