PRouzeau/Lily-Big/STL_Big/Lily_Big_34_part_duct2.stl

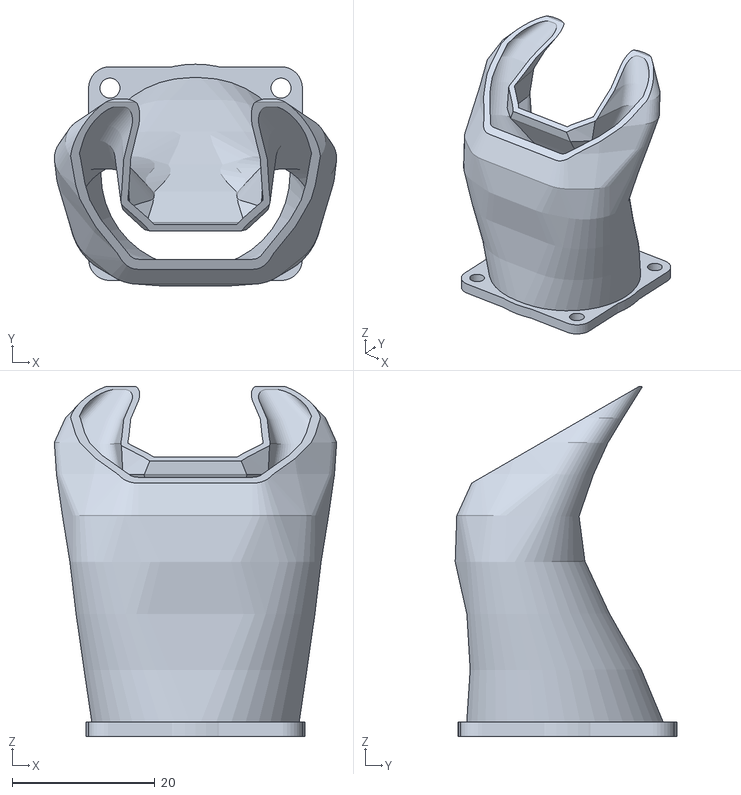
[picture p29: CAD file, 2016-08-03]
STL_Big/Lily_Big_34_part_duct2.stl
39.6 x 31.1 x 49.1
