PRouzeau/Lily-Big/STL_Dirext/Dirext_30_Tensioner.stl

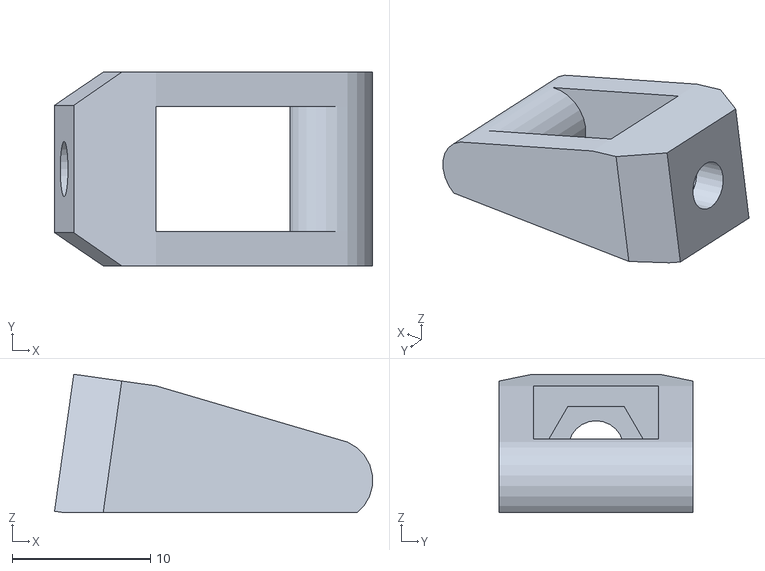
[picture p30: CAD file, 2016-08-03]
STL_Dirext/Dirext_30_Tensioner.stl
23.0 x 14.0 x 10.0
