PRouzeau/Lily-Big/DXF/Lily_Big_57_front_door.dxf

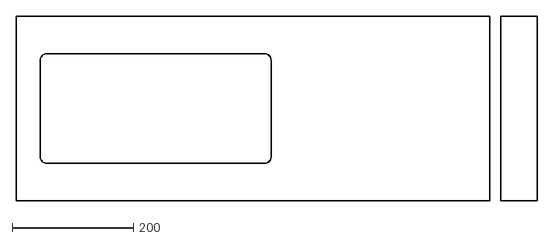
[picture p31: CAD file, 2016-08-03]
DXF/Lily_Big_57_front_door.dxf
858.0 x 304.0
