PRouzeau/Lily-Big/STL_Big/E3D-V6.stl

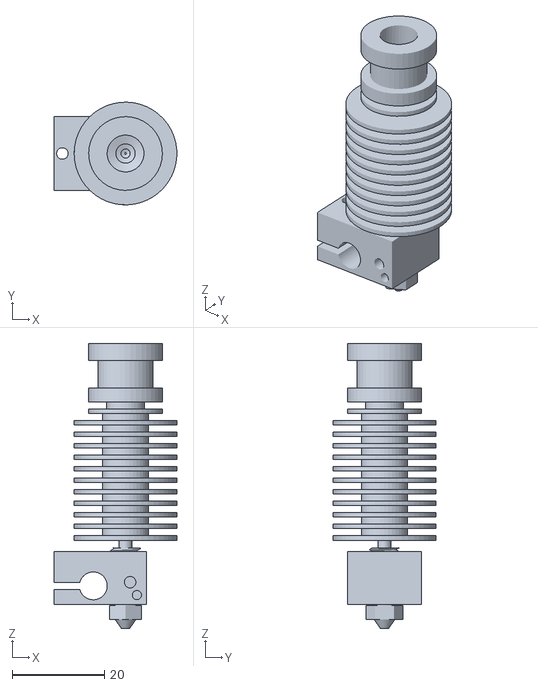
[picture p32: CAD file, 2016-08-03]
STL_Big/E3D-V6.stl
26.6 x 22.3 x 61.9
