PRouzeau/Lily-Big/DXF/Lily_Big_55_left_door.dxf

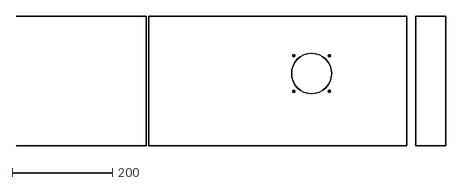
[picture p33: CAD file, 2016-08-03]
DXF/Lily_Big_55_left_door.dxf
858.0 x 259.2
