PRouzeau/Lily-Big/STL_Big/Lily_Big_30_effector_B.stl

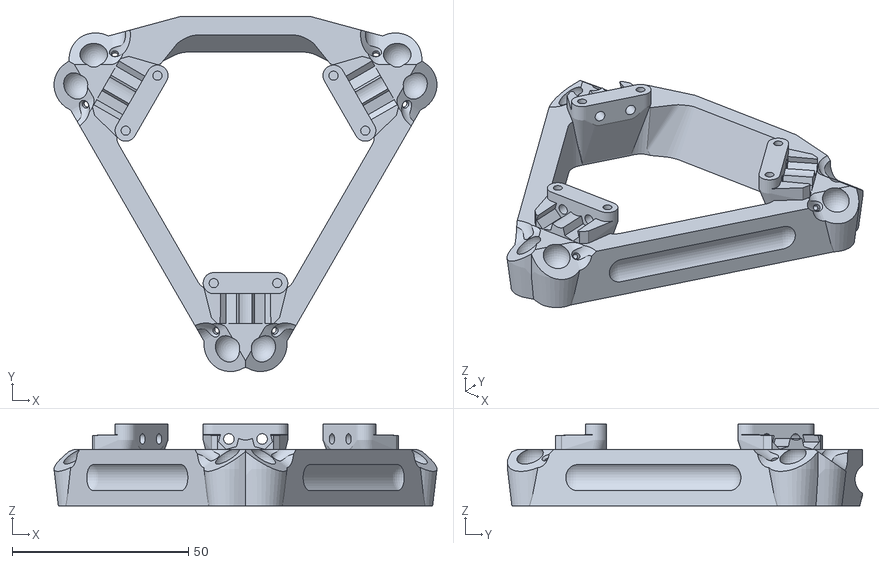
[picture p34: CAD file, 2016-08-03]
STL_Big/Lily_Big_30_effector_B.stl
108.5 x 100.6 x 23.1
