PRouzeau/Lily-Big/STL_Dirext/Dirext_10_Simple_extr_antivib.stl

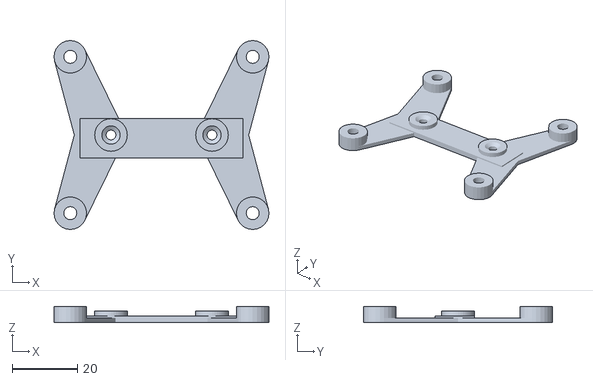
[picture p35: CAD file, 2016-08-03]
STL_Dirext/Dirext_10_Simple_extr_antivib.stl
66.0 x 58.0 x 5.00
