PRouzeau/Lily-Big/DXF/Lily_Big_53_left_side.dxf

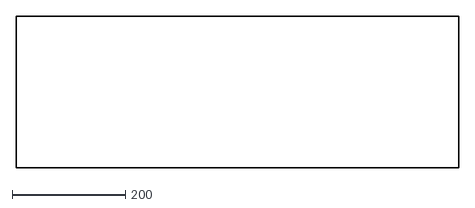
[picture p36: CAD file, 2016-08-03]
DXF/Lily_Big_53_left_side.dxf
780.0 x 267.0
