PRouzeau/Lily-Big/STL_Big/Lily_Big_27_bed_cable_insul.stl

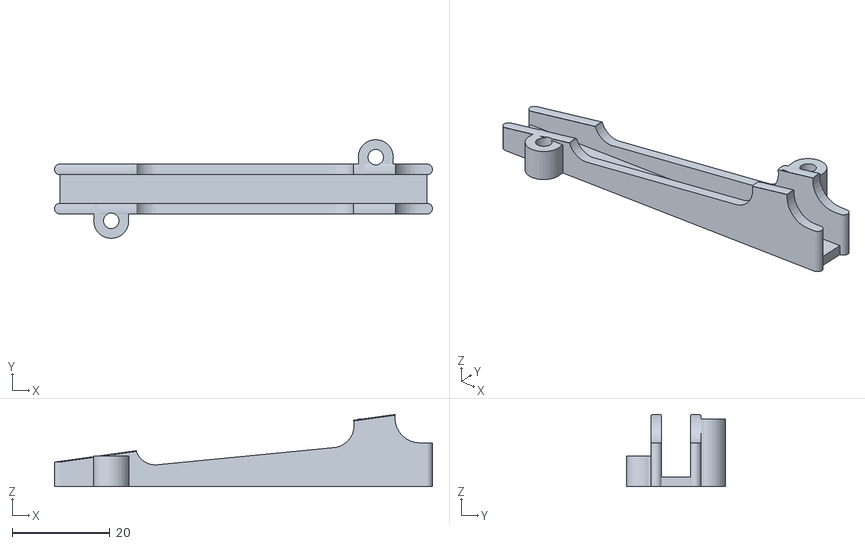
[picture p37: CAD file, 2016-08-03]
STL_Big/Lily_Big_27_bed_cable_insul.stl
77.2 x 20.2 x 14.7
