PRouzeau/Lily-Big/DXF/Lily_Big_56_right_door.dxf

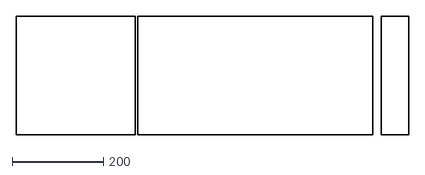
[picture p38: CAD file, 2016-08-03]
DXF/Lily_Big_56_right_door.dxf
858.0 x 259.2
