PRouzeau/Lily-Big/STL_Big/Lily_Big_20_arm_junction.stl

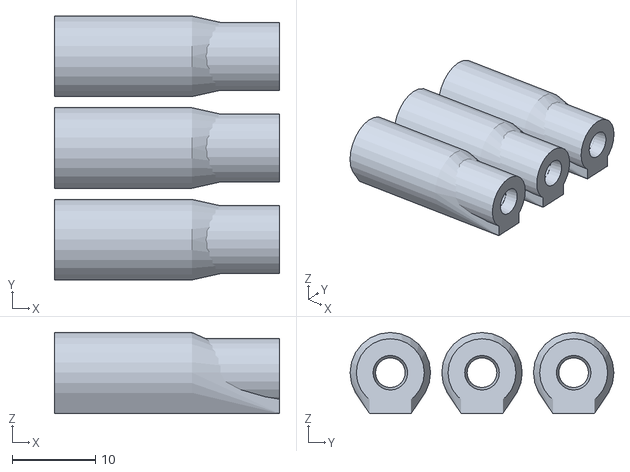
[picture p39: CAD file, 2016-08-03]
STL_Big/Lily_Big_20_arm_junction.stl
27.0 x 31.7 x 9.73
