PRouzeau/Lily-Big/DXF/Lily_Big_65_top_panel.dxf

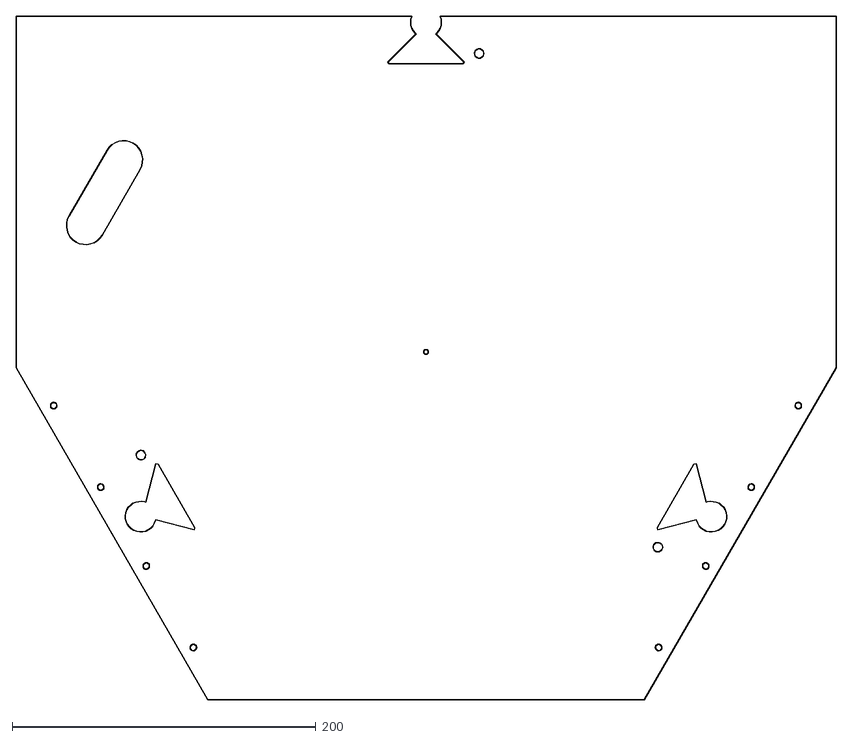
[picture p40: CAD file, 2016-08-03]
DXF/Lily_Big_65_top_panel.dxf
540.0 x 450.0
