PRouzeau/Lily-Big/STL_Big/Lily_Big_23_SSR_protect.stl

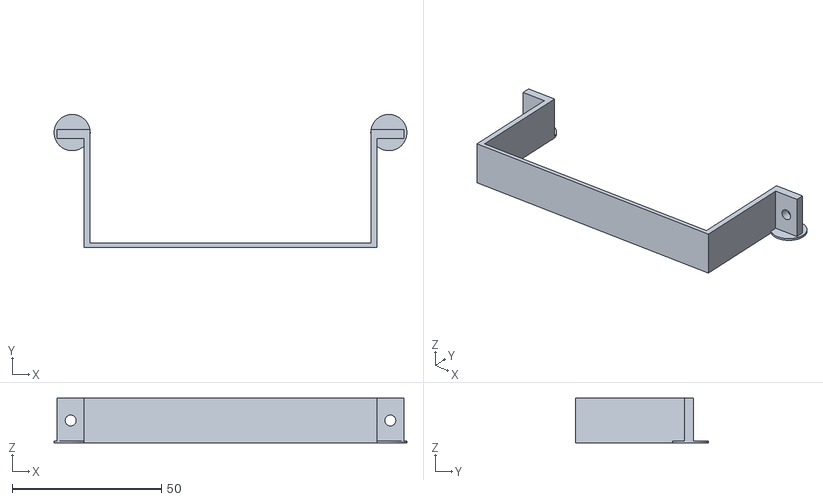
[picture p41: CAD file, 2016-08-03]
STL_Big/Lily_Big_23_SSR_protect.stl
118.2 x 44.6 x 15.0
