PRouzeau/Lily-Big/STL_Big/Lily_Big_21_ref_stick.stl

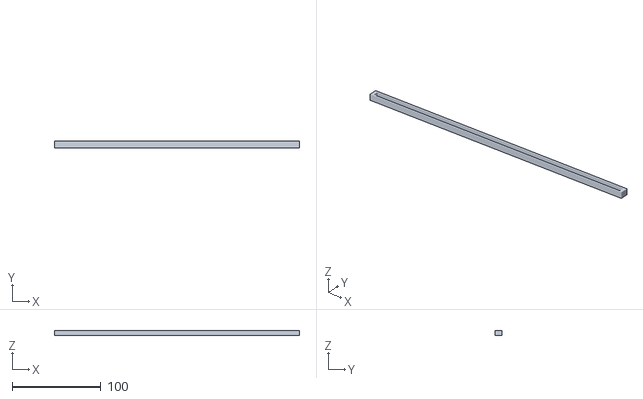
[picture p42: CAD file, 2016-08-03]
STL_Big/Lily_Big_21_ref_stick.stl
276.7 x 8.00 x 6.00
