PRouzeau/Lily-Big/STL_Big/Lily_Big_17_carriage_back.stl

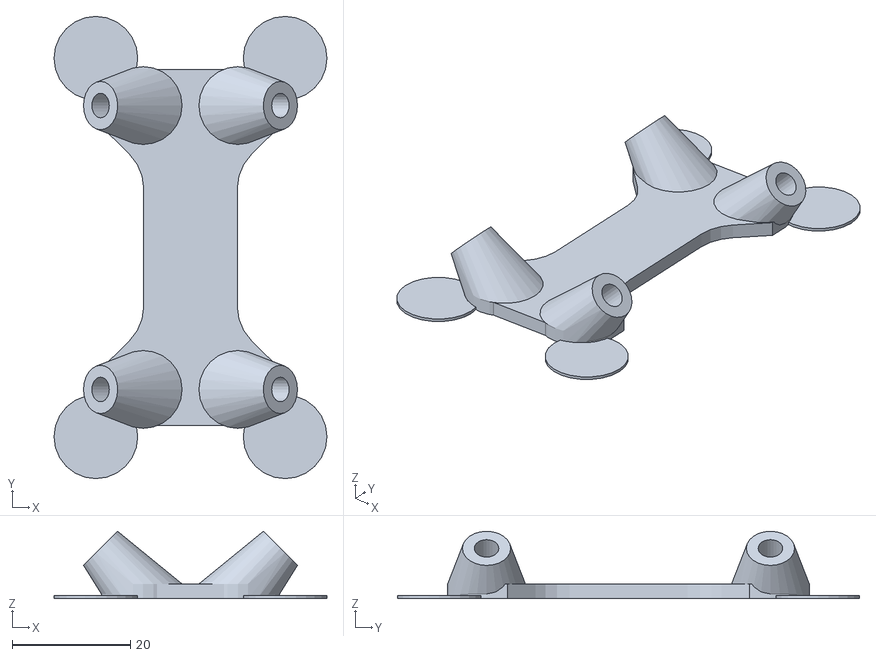
[picture p43: CAD file, 2016-08-03]
STL_Big/Lily_Big_17_carriage_back.stl
46.2 x 78.2 x 11.4
