PRouzeau/Lily-Big/STL_Big/Lily_Big_04_top_reinf.stl

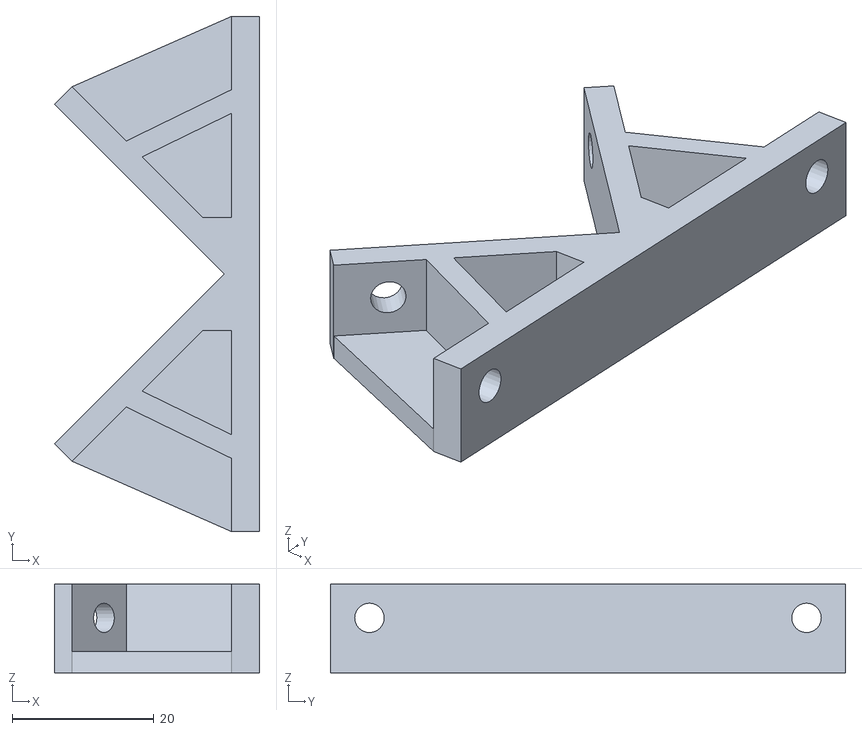
[picture p44: CAD file, 2016-08-03]
STL_Big/Lily_Big_04_top_reinf.stl
29.0 x 72.7 x 12.5
