PRouzeau/Lily-Big/STL_Big/V6.6_Duct.stl

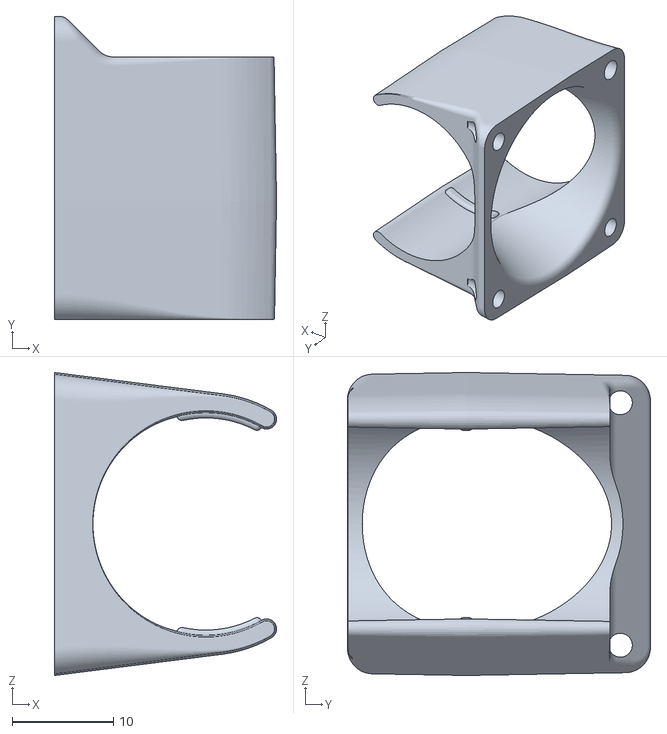
[picture p45: CAD file, 2016-08-03]
STL_Big/V6.6_Duct.stl
22.0 x 30.0 x 30.0
