PRouzeau/Lily-Big/STL_Big/Lily_Big_31_hotend_support_B.stl

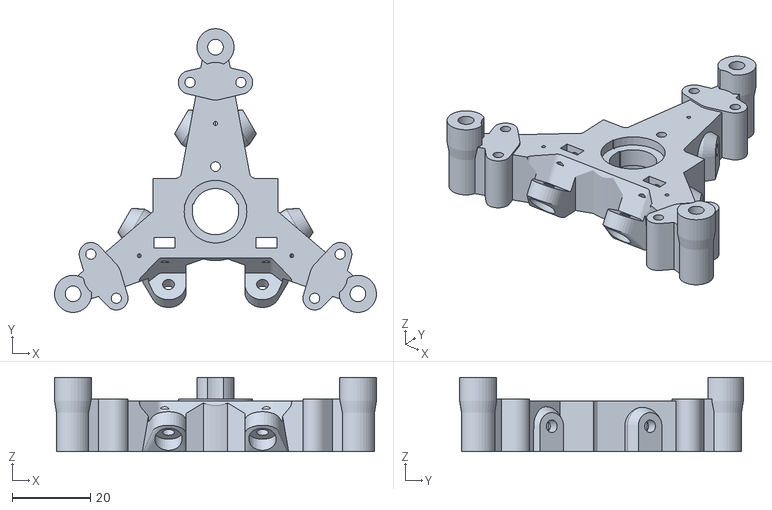
[picture p46: CAD file, 2016-08-03]
STL_Big/Lily_Big_31_hotend_support_B.stl
82.2 x 72.5 x 19.0
