PRouzeau/Lily-Big/STL_Big/Lily_Big_12_tensioner.stl

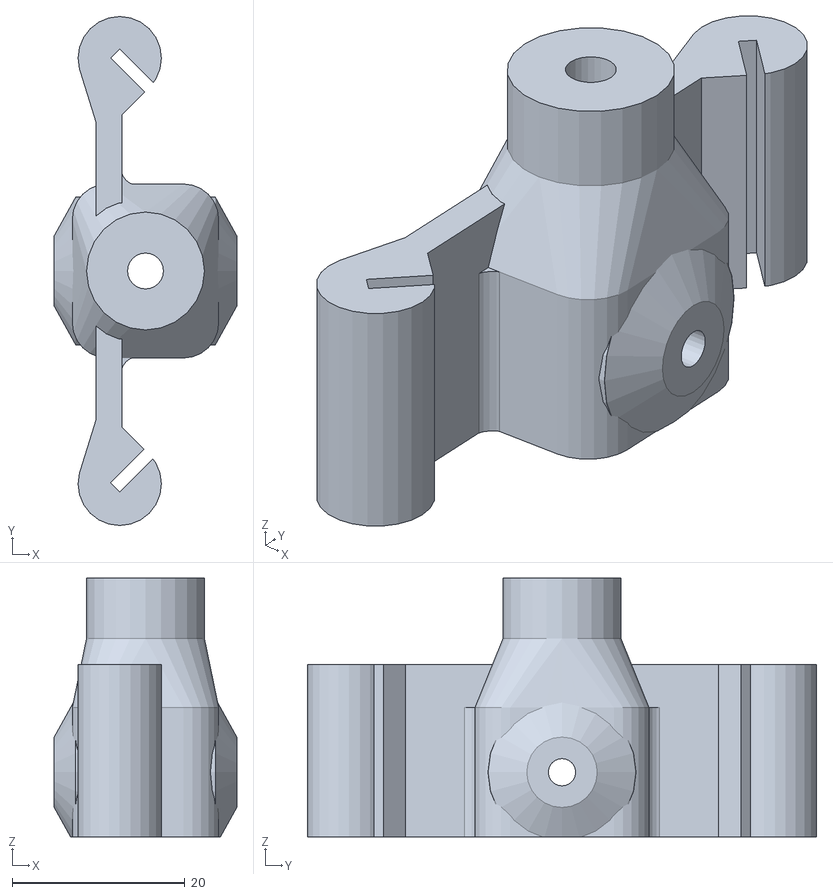
[picture p47: CAD file, 2016-08-03]
STL_Big/Lily_Big_12_tensioner.stl
21.2 x 59.0 x 30.0
