PRouzeau/Lily-Big/STL_Big/Lily_Big_05_angle_plug.stl

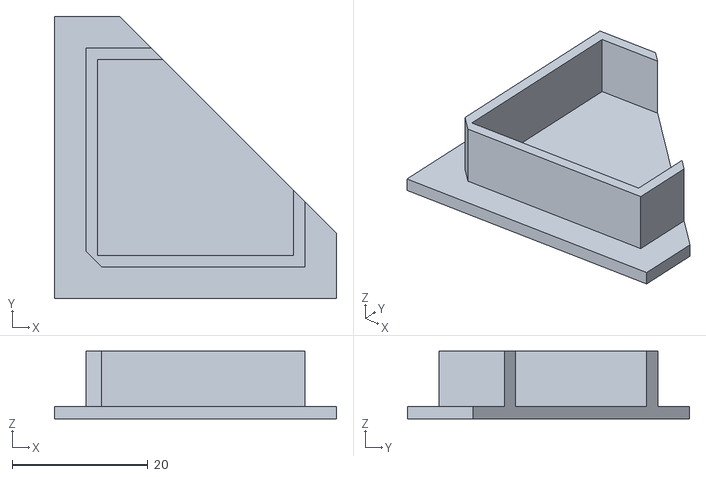
[picture p48: CAD file, 2016-08-03]
STL_Big/Lily_Big_05_angle_plug.stl
41.5 x 41.5 x 10.0
