PRouzeau/Lily-Big/STL_Big/Lily_Big_18_ball_cup.stl

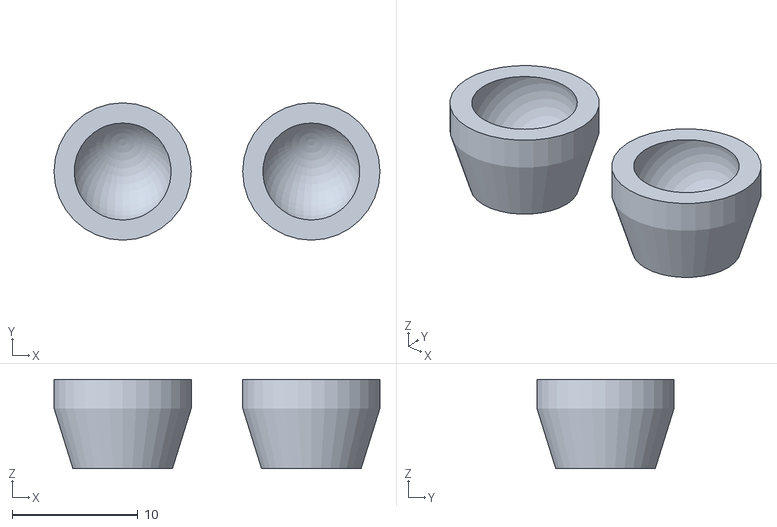
[picture p49: CAD file, 2016-08-03]
STL_Big/Lily_Big_18_ball_cup.stl
25.9 x 10.9 x 7.10
