PRouzeau/Lily-Big/STL_Big/Lily_Big_36_air_guide.stl

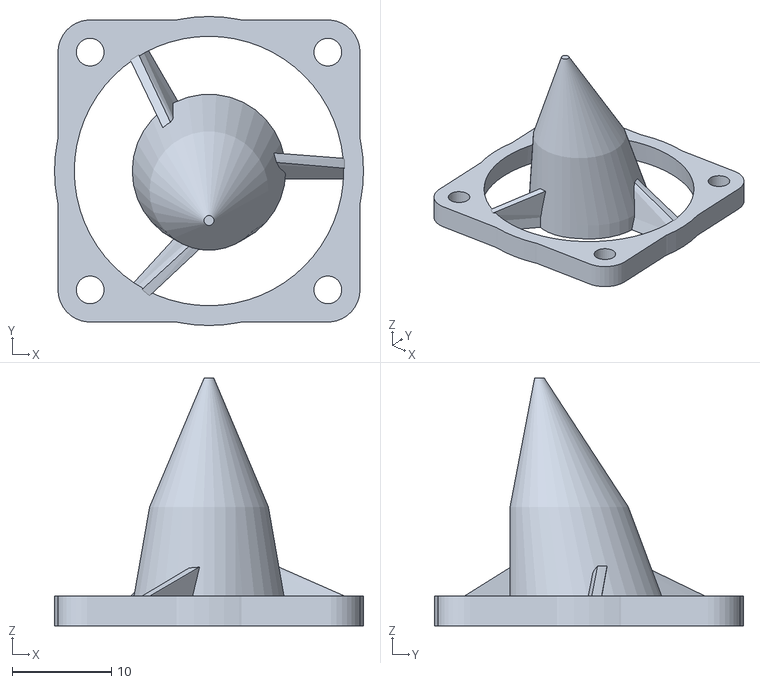
[picture p50: CAD file, 2016-08-03]
STL_Big/Lily_Big_36_air_guide.stl
31.2 x 31.2 x 25.0
