PRouzeau/Lily-Big/STL_Big/Lily_Big_44_glass_retainer.stl

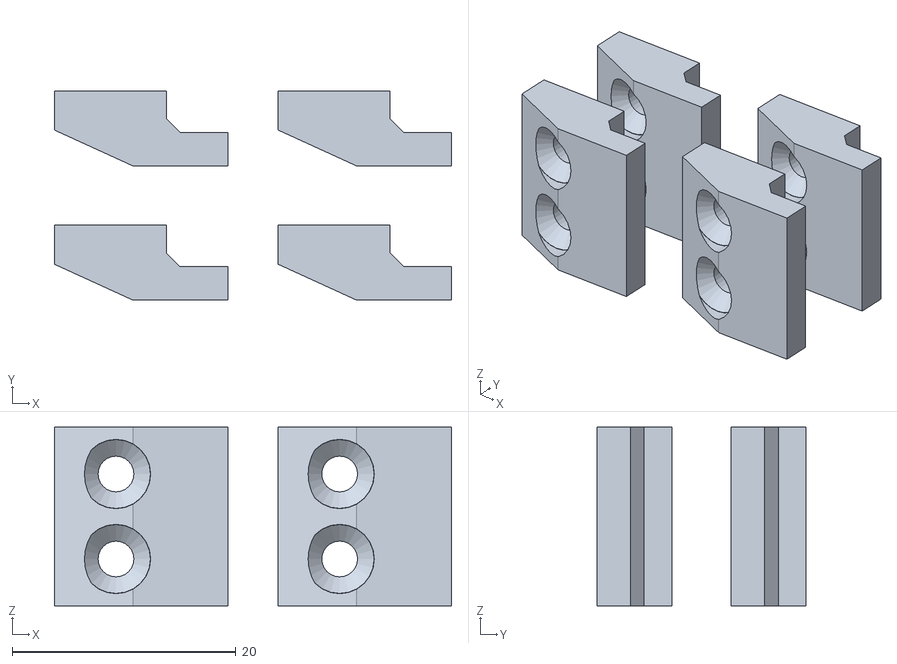
[picture p51: CAD file, 2016-08-03]
STL_Big/Lily_Big_44_glass_retainer.stl
35.5 x 18.7 x 16.0
