PRouzeau/Lily-Big/STL_Big/Lily_Big_15_carriage.stl

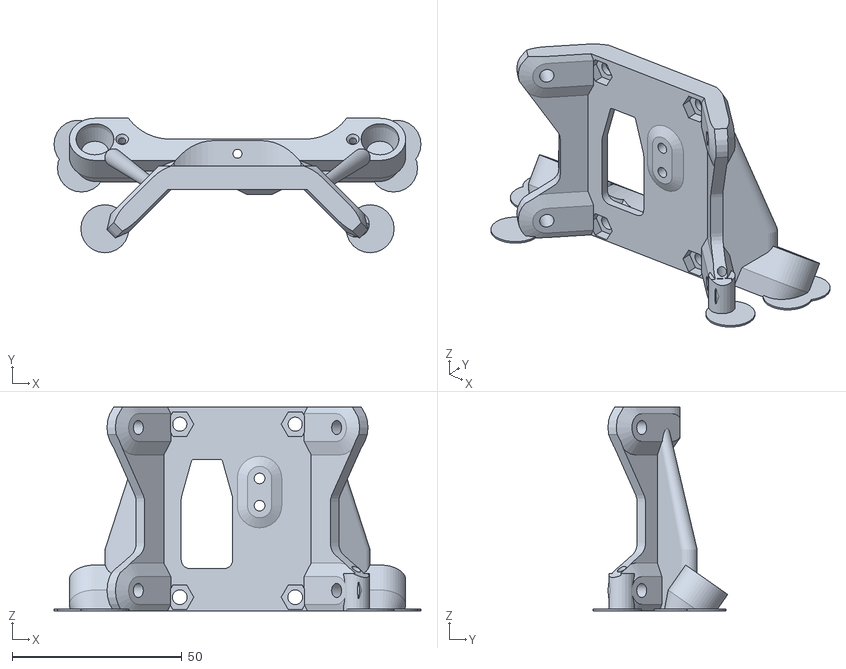
[picture p52: CAD file, 2016-08-03]
STL_Big/Lily_Big_15_carriage.stl
108.2 x 39.6 x 60.0
