PRouzeau/Lily-Big/STL_Big/Lily_Big_26_door_pads.stl

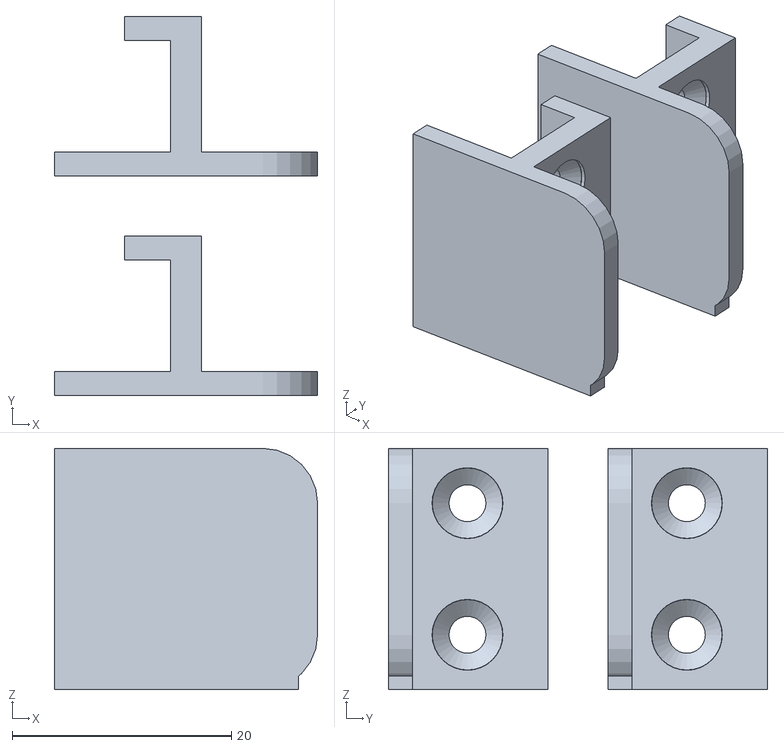
[picture p53: CAD file, 2016-08-03]
STL_Big/Lily_Big_26_door_pads.stl
24.0 x 34.6 x 22.0
