PRouzeau/Lily-Big/STL_Big/Lily_Big_39_prometheus_duct_30mm.stl

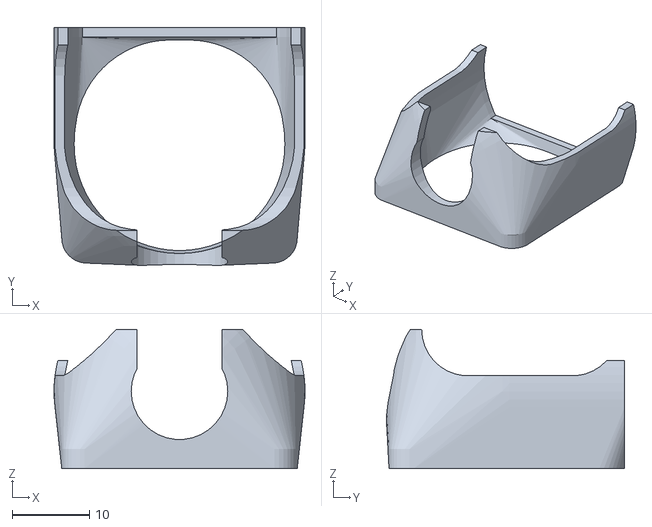
[picture p54: CAD file, 2016-08-03]
STL_Big/Lily_Big_39_prometheus_duct_30mm.stl
32.5 x 30.8 x 18.0
