PRouzeau/Lily-Big/STL_Big/Lily_Big_38_hotend_support_B2.stl

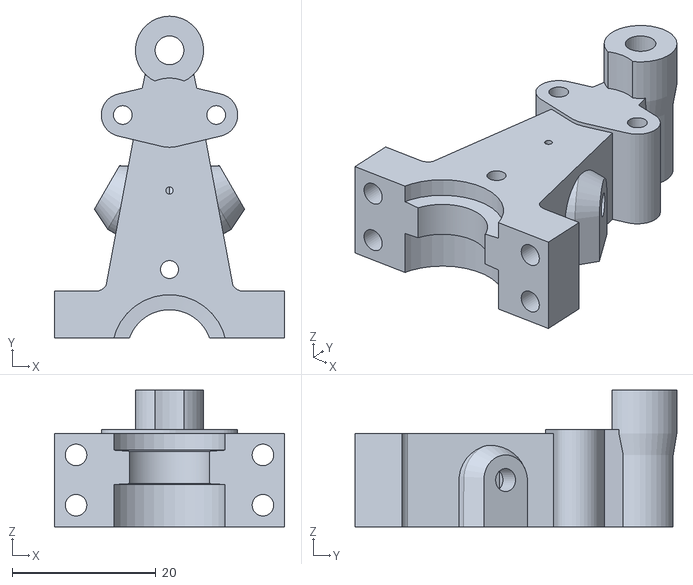
[picture p55: CAD file, 2016-08-03]
STL_Big/Lily_Big_38_hotend_support_B2.stl
32.0 x 44.8 x 19.0
