PRouzeau/Lily-Big/STL_Big/Lily_Big_13_tensioner_wheel.stl

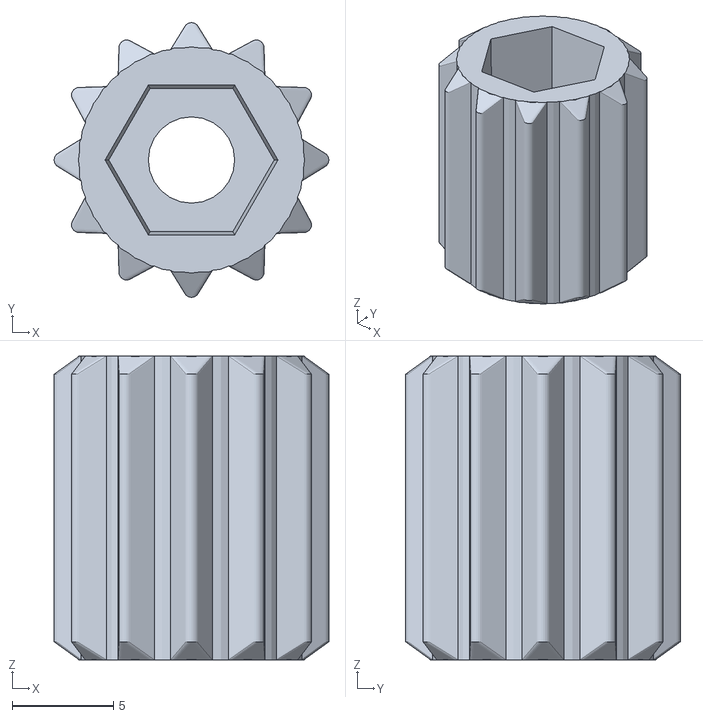
[picture p56: CAD file, 2016-08-03]
STL_Big/Lily_Big_13_tensioner_wheel.stl
13.6 x 13.6 x 15.0
