PRouzeau/Lily-Big/STL_Big/Lily_Big_32_mag_holder.stl

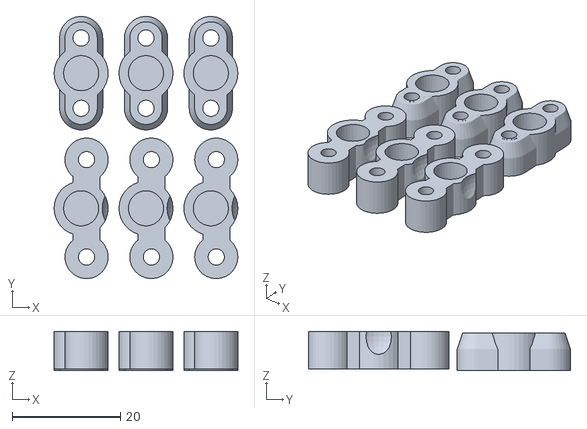
[picture p57: CAD file, 2016-08-03]
STL_Big/Lily_Big_32_mag_holder.stl
34.0 x 48.5 x 7.30
