PRouzeau/Lily-Big/STL_Big/Prometheus3nuts.stl

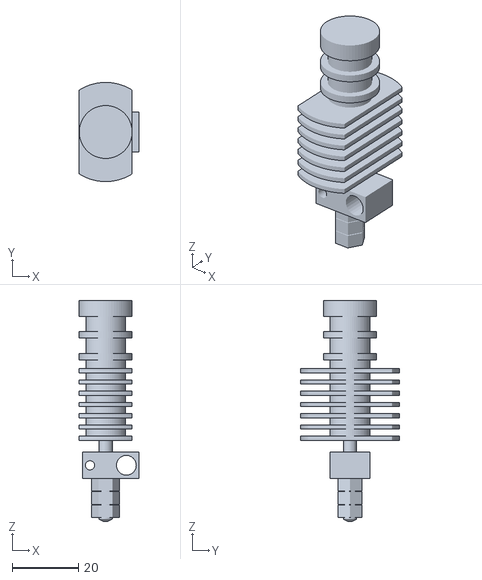
[picture p58: CAD file, 2016-08-03]
STL_Big/Prometheus3nuts.stl
18.0 x 30.0 x 66.8
