PRouzeau/Lily-Big/STL_Big/Lily_Big_02_foot_Big.stl

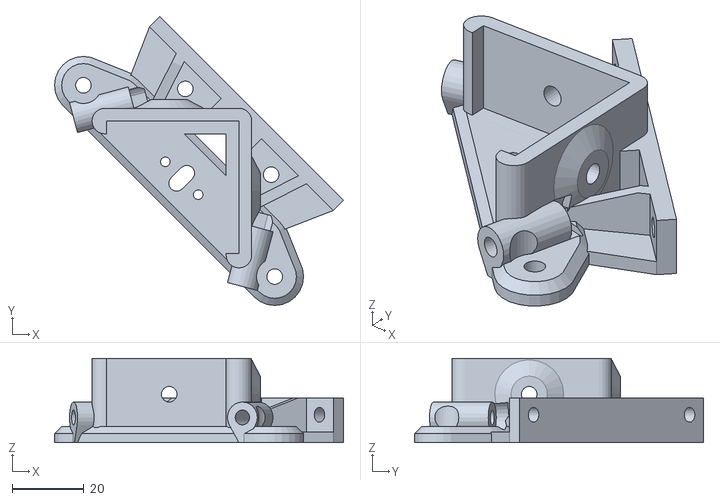
[picture p59: CAD file, 2016-08-03]
STL_Big/Lily_Big_02_foot_Big.stl
80.8 x 80.8 x 23.5
