PRouzeau/Lily-Big/STL_Big/Lily_Big_35_part_duct3.stl

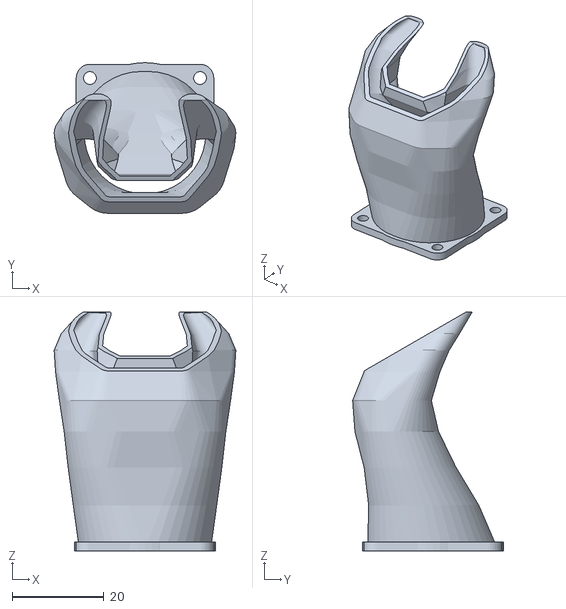
[picture p60: CAD file, 2016-08-03]
STL_Big/Lily_Big_35_part_duct3.stl
39.6 x 32.9 x 52.1
