PRouzeau/Lily-Big/STL_Big/Lily_Big_29_ESD_shield.stl

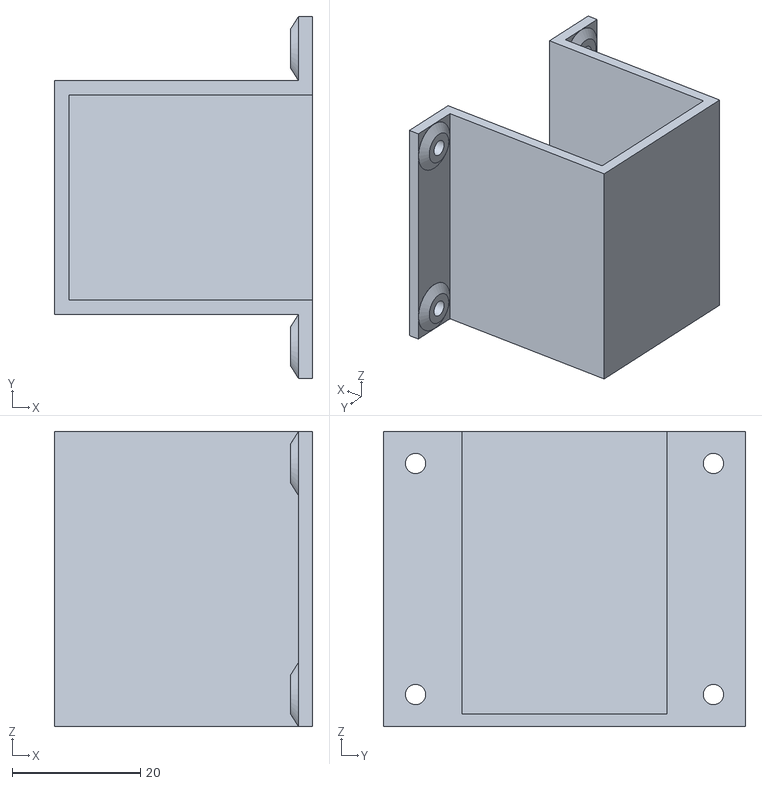
[picture p61: CAD file, 2016-08-03]
STL_Big/Lily_Big_29_ESD_shield.stl
40.2 x 56.4 x 46.0
