PRouzeau/Lily-Big/STL_Big/Lily_Big_03_motor_support_Big.stl

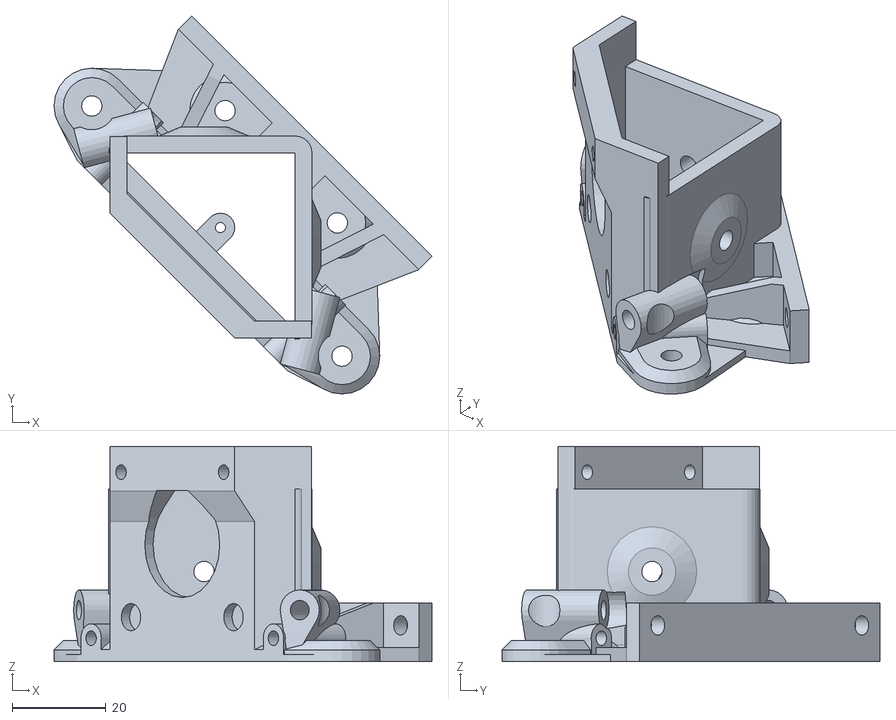
[picture p62: CAD file, 2016-08-03]
STL_Big/Lily_Big_03_motor_support_Big.stl
80.8 x 80.8 x 46.0
