PRouzeau/Lily-Big/STL_Big/Lily_Big_28_cable_stops.stl

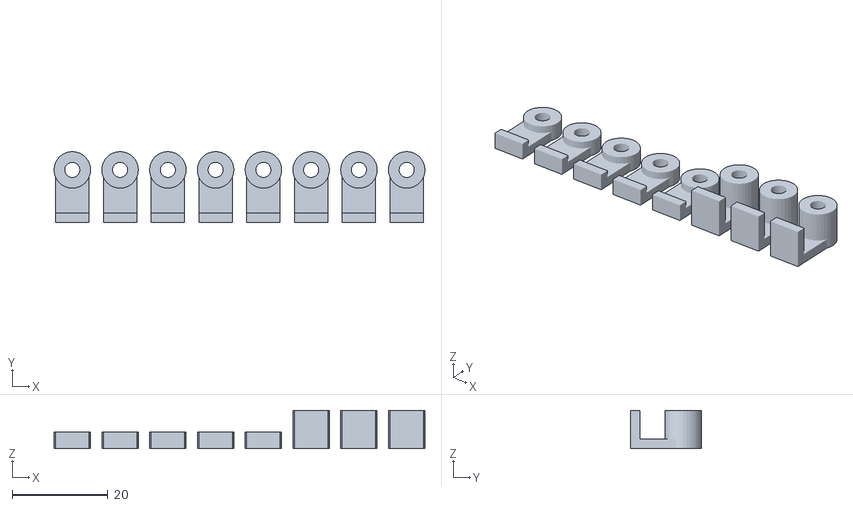
[picture p63: CAD file, 2016-08-03]
STL_Big/Lily_Big_28_cable_stops.stl
77.7 x 14.8 x 8.00
