PRouzeau/Lily-Big/STL_Big/Lily_Big_16_carriage_center.stl

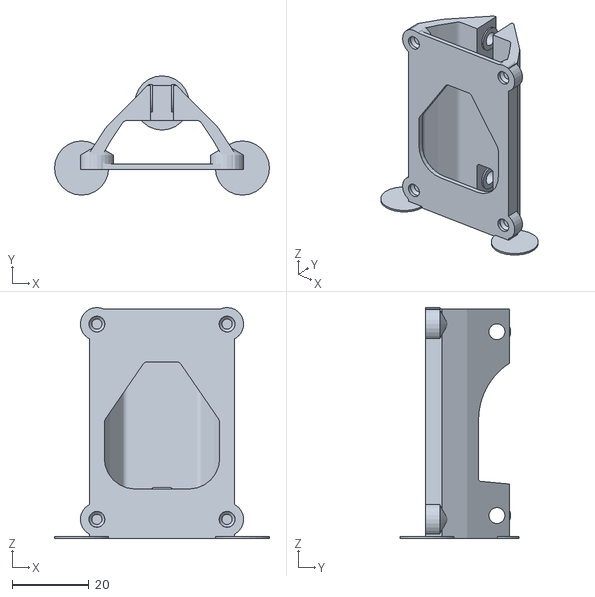
[picture p64: CAD file, 2016-08-03]
STL_Big/Lily_Big_16_carriage_center.stl
56.2 x 31.2 x 60.3
