PRouzeau/Lily-Big/(list of files, cad)

Other CAD files:
STL_Dirext/Dirext_25_Lever_Pushfit_mirrored.stl
STL_Dirext/Dirext_14_Simple_extr_filguide_vert.stl
STL_Dirext/Dirext_11_Simple_extr_antivib_mirrored.stl
STL_Dirext/Dirext_08_Simple_extr_base.stl
STL_Dirext/Dirext_23_Lever_NutM4_mirrored.stl
STL_Big/Lily_Big_14_nut_retainer.stl
