PRouzeau/Lily-Big/(commit log)

2016-08-03 Boxed Delta printer
    Boxed Delta printer. Recycling filtration, kinematic positioned
    effector and steel on steel carriage roll bearings.
    [Delta_simulator.scad, Dirext_08_Simple_extr_base.stl, Dirext_09_Simple_extr_base_mirrored.stl, Dirext_10_Simple_extr_antivib.stl, Dirext_11_Simple_extr_antivib_mirrored.stl, Dirext_14_Simple_extr_filguide_vert.stl, Dirext_15_Simple_extr_filguide_vert_mirrored.stl, Dirext_22_Lever_NutM4.stl]
2016-08-04 BOM update, add readme
    [Lily_big_BOM.ods]
